Y-K1n9/Audio-Amplifier/Report/Full Circuit Analysis.pdf

1 | P a g e

# PROJECT

# SIMULATION

# AUDIO AMPLIFIER

# TEAM

### YOGESH KRISHNA – 2024102035 ANUMAY RAI – 2025122013

## TABLE NUMBER – 10 ROOM – N117

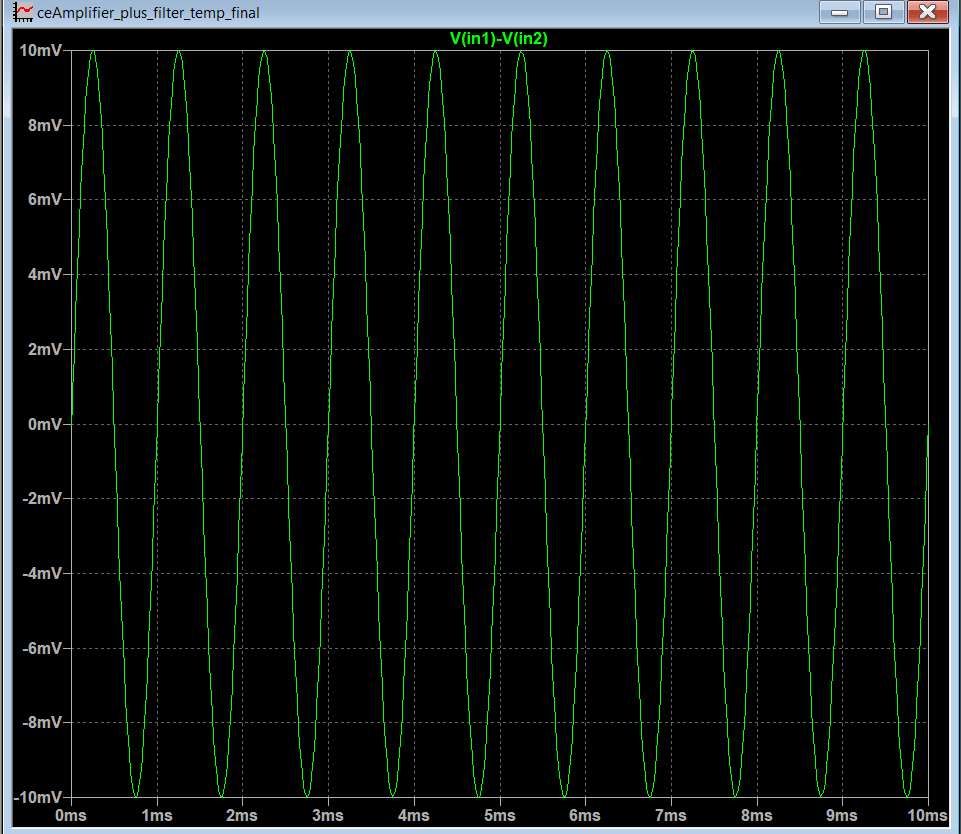
[picture p1: figure]
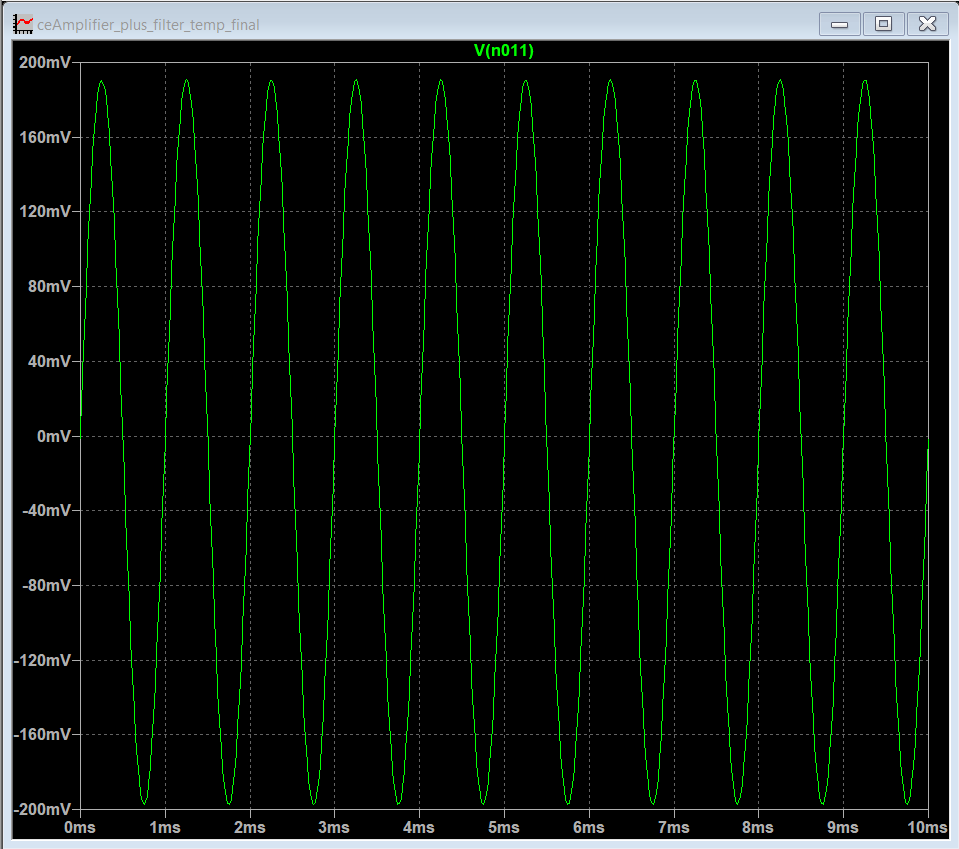
[picture p2: figure]

2 | P a g e

Input Voltage

Output of Differential Circuit

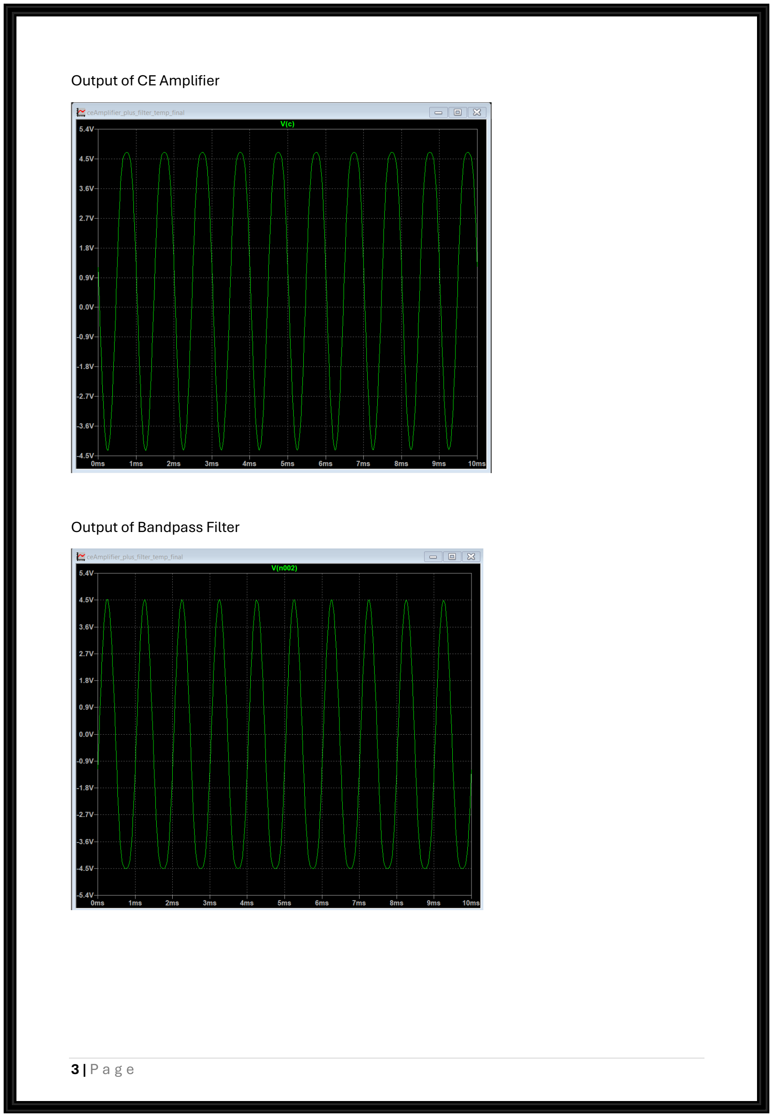
[picture p3: page 3]

3 | P a g e

Output of CE Amplifier

Output of Bandpass Filter

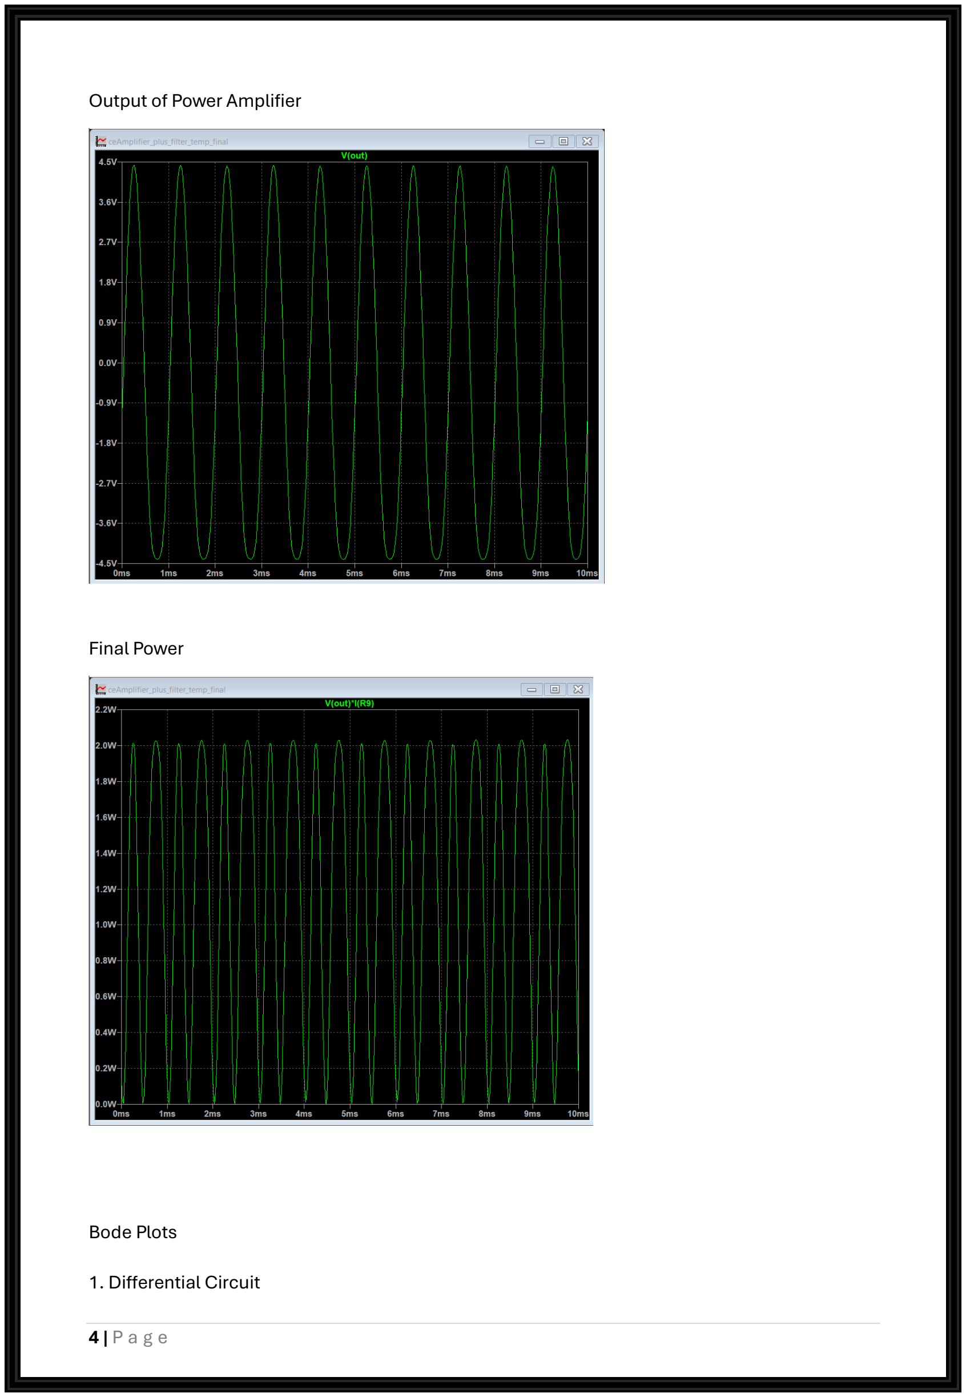
[picture p4: page 4]

4 | P a g e

Output of Power Amplifier

Final Power

Bode Plots

1. Differential Circuit

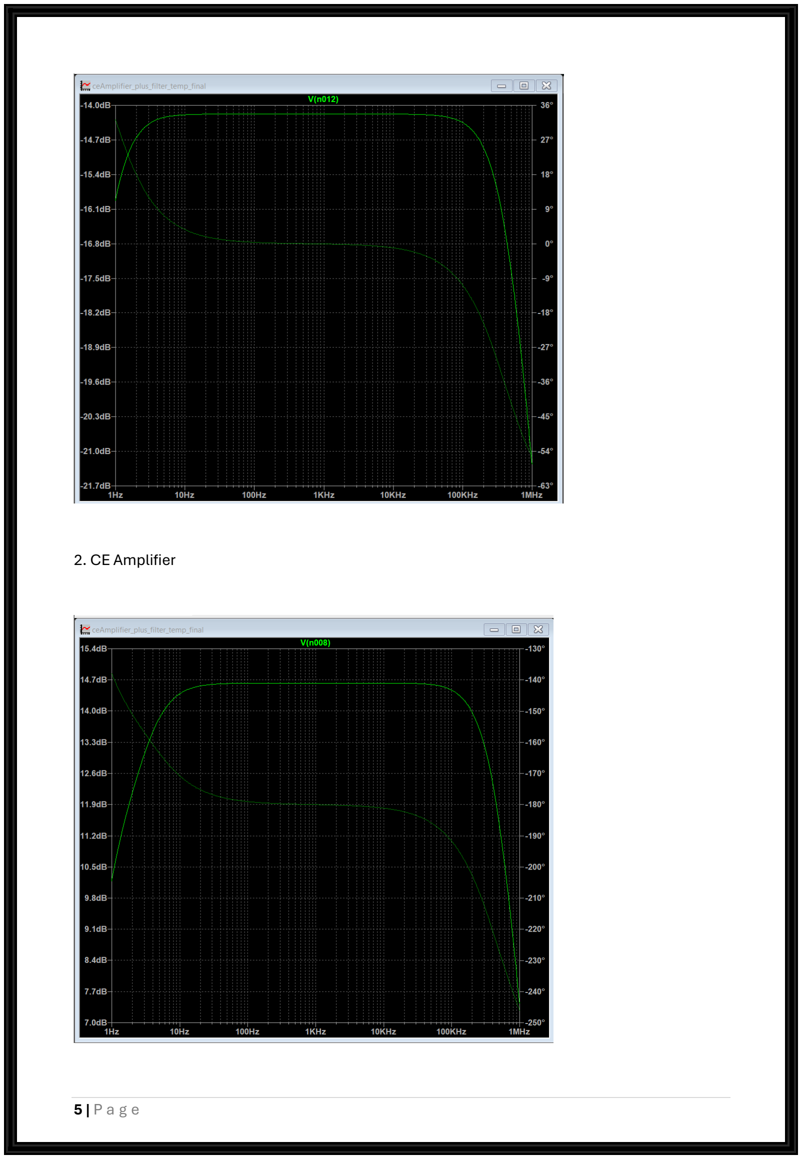
[picture p5: page 5]

5 | P a g e
2. CE Amplifier

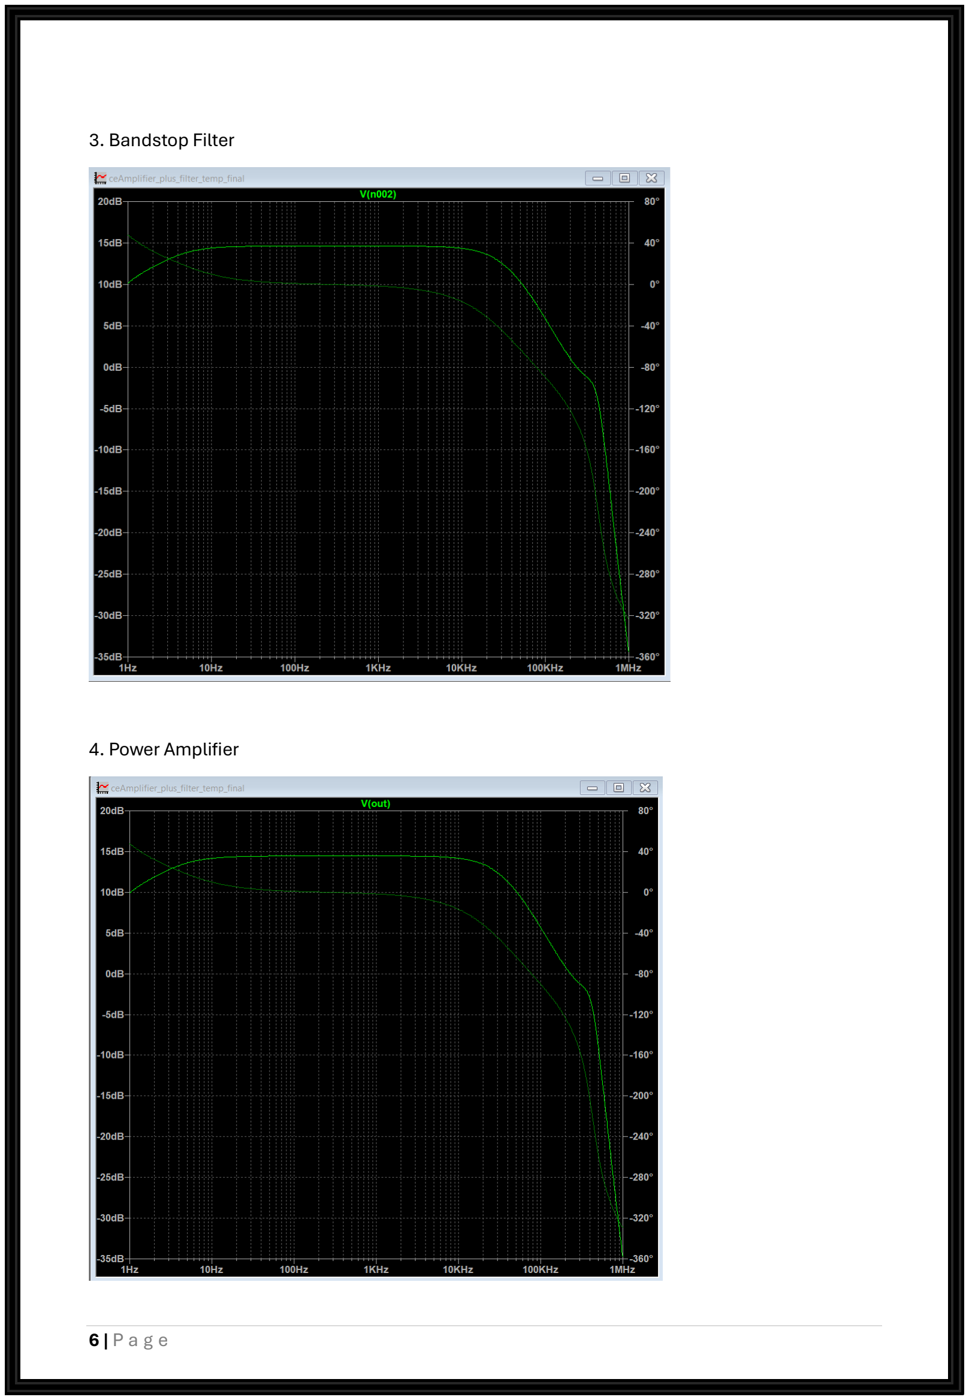
[picture p6: page 6]

6 | P a g e
3. Bandstop Filter
4. Power Amplifier

7 | P a g e

Gain Stages
1. Pre- Amplifier Gain –
a) 20mV pk-pk at 1kHz = 19.2
b) 10mV pk-pk at 1KHz = 19.4
2. Amplifier Gain
a) 20mV pk-pk at 1KHz = 24.0
b) 10mV pk-pk at 1KHz = 26.8
3. Filter Gain
c) 20mV pk-pk at 1KHz = 1
d) 10mV pk-pk at 1KHz = 1
4. Amplifier Gain
e) 20mV pk-pk at 1KHz = 0.97
f) 10mV pk-pk at 1KHz = 0.98
5. Overall Gain
g) 20mV pk-pk at 1KHz = 449.5
h) 10mV pk-pk at 1KHz = 508.9
6. Overall Gain(Without Power Amplifier)
i) 20mV pk-pk at 1KHz = 459.5
j) 10mV pk-pk at 1KHz = 519.3

Parameters
1. Common Mode Rejection Ratio(CMRR) = 30.4dB
2. Slew Rate = 0.057 V/μs
3. Total Harmonic Distortion (THD)
a) 20mV pk-pk at 1kHz = 11.862086%
b) 10mV pk-pk at 1kHz = 3.893069%
4. Stability Factor (S) = 11.1048
