Y-K1n9/Audio-Amplifier/Report/Table_10_2024102035_2025122013 (1).pdf

## EW2 Project 1

## Audio Amplifier Design Report

Team 10

Anumay Rai, 2025122013
Yogesh Krishna, 2024102035

March 5, 2026

## Contents

1 Introduction | 4
2 Microphone Input Circuit | 5
3 Differential Amplifier (Pre-Amplifier Stage) | 6
4 Common-Emitter (CE) Gain Stage | 16

EW2 Project 1 — Audio Amplifier Design | Team 10
5 Active Band-Pass Filter Stage (20 Hz – 20 kHz) | 26
6 Power Amplifier Stage (Class AB) | 32

7 Overall Performance and Analysis | 40
8 Conclusion | 50
9 Link to Demo on Hardware Circuit | 50

## 1 Introduction

### 1.1 Project Overview

The objective of this project is to design a multi-stage audio amplifier capable of ampli-fying weak audio signals to a level suitable for driving a loudspeaker. The design must operate within the audio frequency band of 20 Hz to 20 kHz, provide sufficient voltage and power gain, and maintain low distortion.

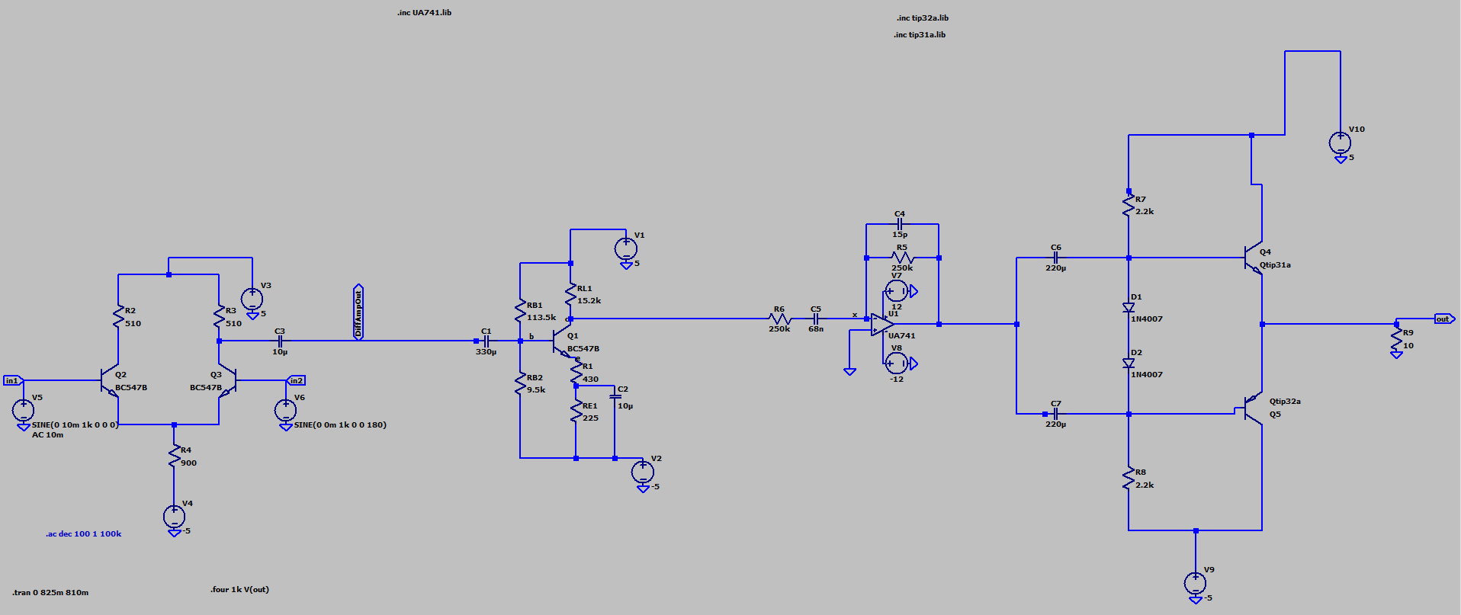
[picture p7: figure]

Figure 1: LTSpice Schematic of Audio Amplifier

### 1.2 Amplifier Architecture

The amplifier comprises four cascaded stages:

1. Differential Amplifier (Pre-Amplifier): Provides initial voltage gain with high common-mode rejection.
2. Common-Emitter (CE) Gain Stage: Provides the bulk of the voltage gain.
3. Active Band-Pass Filter: Limits the signal bandwidth to the audio range (20 Hz
- 20 kHz) with unity or sub-unity gain.
4. Class AB Power Amplifier: Provides current gain (power gain) to drive a low-impedance load (speaker) at unity voltage gain.

### 1.3 Supply Voltage

The circuit operates with a dual-rail supply of VCC = +5 V and VEE = −5 V.

### 1.4 Hardware Implementation of Amplifier Circuit

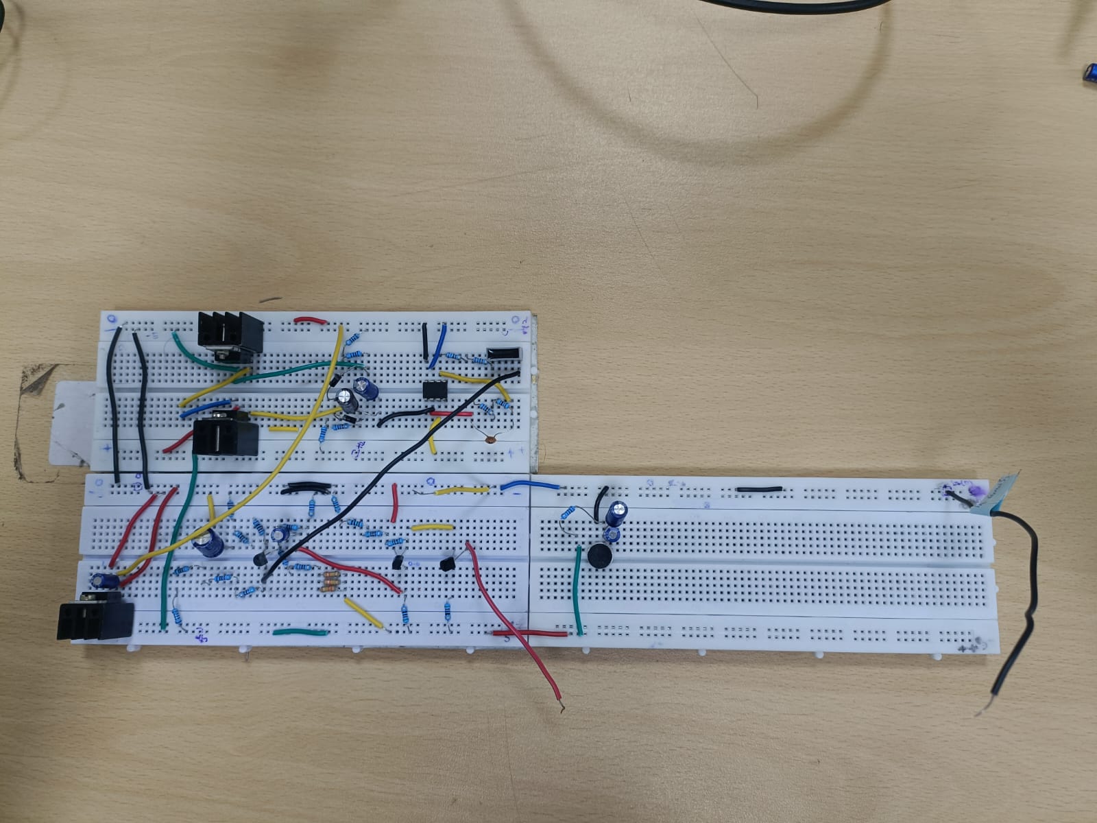
[picture p8: figure]

Figure 2: Hardware Implementation of Amplifier Circuit.

## 2 Microphone Input Circuit

The input signal for the amplifier is obtained from an electric condenser microphone. Such microphones contain a small internal JFET that requires a DC bias current for proper operation. Therefore, a simple biasing circuit is used to provide this current while allowing the generated AC audio signal to be extracted.

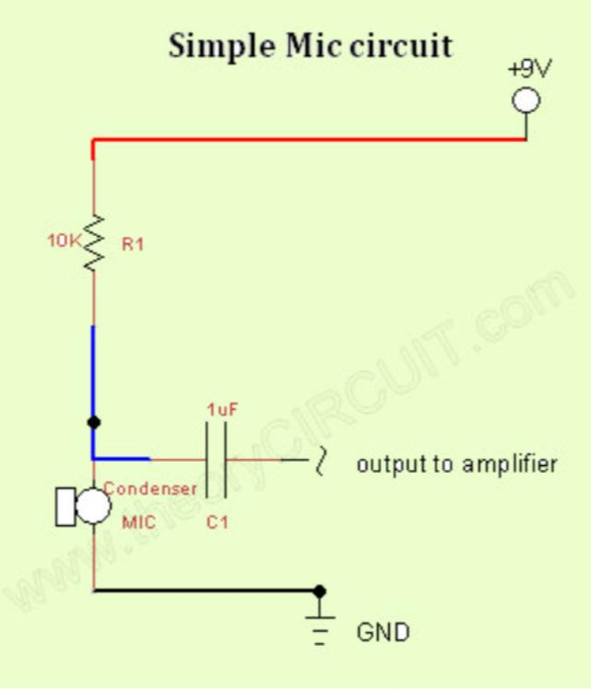
[picture p9: figure]

Figure 3: Electric microphone biasing circuit

The circuit consists of a bias resistor R1(=10kΩ in hardware), a coupling capacitor C1(=57µF in hardware), and the microphone. The resistor R1 connects the microphone to the supply voltage and provides the necessary operating current for the internal JFET to operate in active region.

## 3 Differential Amplifier (Pre-Amplifier Stage)

### 3.1 Theory and Circuit Description

The BJT differential pair is one of the most fundamental building blocks in analog circuit design. It consists of two matched BJT transistors whose emitters are connected together through a common tail resistor RE (or a current source). The circuit amplifies the difference between two input signals while rejecting signals common to both inputs.

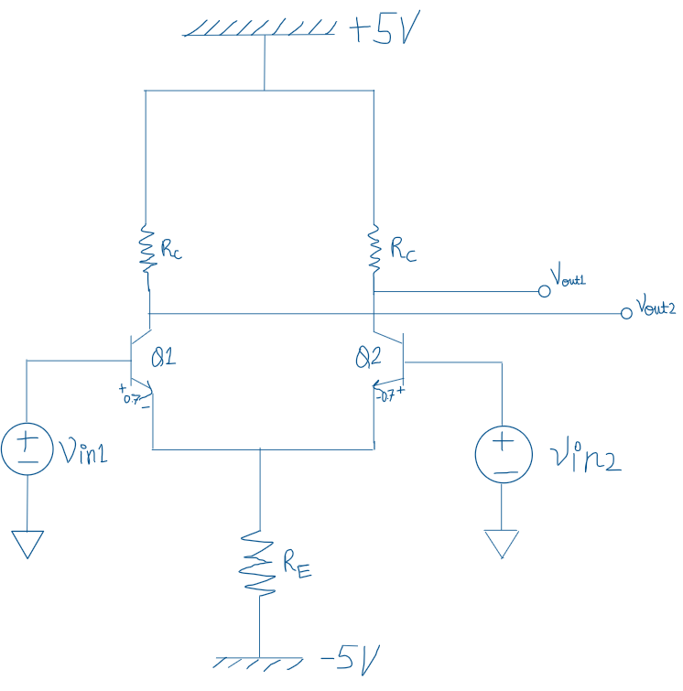
[picture p10: figure]

Figure 4: BJT Differential Pair circuit schematic.

Pre-Amplifier Stage

- The input signal from the microphone cannot be directly fed to the common-emitter or power amplifier because it is very small and susceptible to noise.
- A pre-amplifier is used to increase the signal level to a suitable value (line level) before further amplification.
- The pre-amplifier should have:

– High input impedance to avoid loading the input source.

– Low output impedance to prevent voltage drop at the output.

- In this design, the pre-amplifier stage is implemented using a differential amplifier with a single-ended (unbalanced) output configuration, where one input is connected to the microphone and the other is grounded.

### 3.2 DC Bias Analysis

### 3.2.1 Assumptions

We assume that the base current is negligible (IB ≈ 0 A), which is valid for high-β transistors. Since both transistors are matched:

IC1 = IC2, | IE1 = IE2

and IC ≈ IE (since β ≫ 1).

### 3.2.2 KVL Analysis

Applying KVL from the base of BJT 1 through the emitter to VEE:

−0.7 − IERE = −5

IERE = 4.3

IE =

4.3
RE

(1)

Applying KCL at the emitter node:

IE1 + IE2 = IE | (2)

Since both transistors are matched: IE1 = IE2 =

IE
2

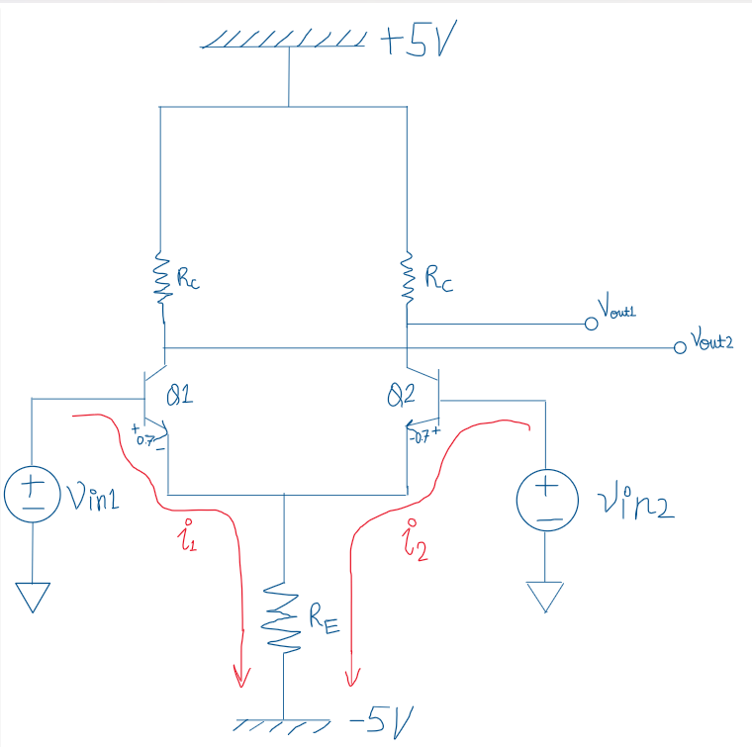
[picture p11: figure]

Figure 5: BJT Differential Pair circuit schematic.

### 3.3 Small-Signal AC Analysis and Gain Derivation

### 3.3.1 Small-Signal Model

In the small-signal analysis, all DC sources are set to zero and the transistors are replaced by their hybrid-π equivalent models. The key small-signal parameter is:

re =

VT
IE

=

1
gm

where VT ≈ 25 mV at room temperature (300 K) and gm is the transconductance.

### 3.3.2 Derivation of Differential Gain

Applying KVL in BJT 1 and BJT 2 small-signal loops:

vin1 − ie1re − (ie1 + ie2)RE = 0 | (1)
vin2 − ie2re − (ie1 + ie2)RE = 0 | (2)

Rearranging into standard form:

ie1(re + RE) + ie2RE = vin1 | (3)
ie1RE + ie2(re + RE) = vin2 | (4)

In matrix form:
re + RE | RE
RE | re + RE

ie1

ie2

=
vin1

vin2

The determinant of the coefficient matrix is:

∆ = (re + RE)

2 − R

2
E = r

2
e + 2REre

By Cramer’s rule:

ie1 =

(RE + re)vin1 − REvin2
r

2
e + 2REre

(3)

ie2 =

(RE + re)vin2 − REvin1
r

2
e + 2REre

(4)

The differential output voltage is:

vout = vo2 − vo1 = (ie1 − ie2)RC

Substituting equations (3) and (4):

vout =

(RE + re)vin1 − REvin2
r

2
e + 2REre

−

(RE + re)vin2 − REvin1
r

2
e + 2REre
RC

=

(RE + re)(vin1 − vin2) + RE(vin1 − vin2)
r

2
e + 2REre
- RC

=

(2RE + re)(vin1 − vin2)
re(re + 2RE)
- RC

=

RC
re
(vin1 − vin2) | (5)

Since the differential input vin = vin1 − vin2:

Ad =

vout

vin

= −

RC
re
= −gmRC | (6)

This is the standard differential gain formula for a BJT differential pair. The negative sign indicates signal inversion.

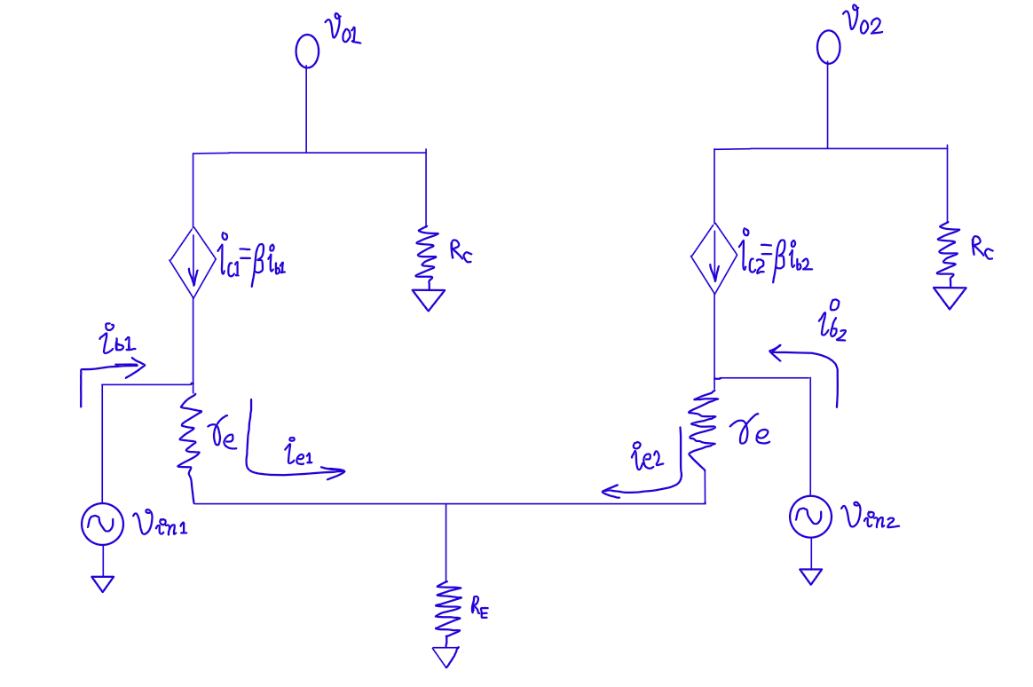
[picture p12: figure]

Figure 6: BJT Differential Pair circuit schematic.

### 3.4 Component Value Design

Setting the target differential gain |Ad| = 49:

gmRC = 49 =⇒

ICRC
VT

= 49

Since IC ≈

IE
2

and the tail current is

IE =

4.3
RE
we have

IC =

4.3
2RE
Substituting:

49 =

ICRC
VT

49 =

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
49 × 2VT
4.3

=

49 × 2 × 0.025
4.3

=

2.45
4.3

≈ 0.57

Chosen component values:

RE = 900 Ω, | RC = 510 Ω | (7)

Verification:

IE =

4.3
900 | = 4.78 mA

IE1 = IE2 =

4.78
2

= 2.39 mA

gm =

IC
VT

=

2.39 × 10⁻³
25 × 10⁻³

= 0.0956 S

Achieved differential gain:

|Ad| = gmRC

|Ad| = 0.0956 × 510 ≈ 48.8

|Ad| ≈ 49

Reason for Gain Reduction in Simulation:
The calculated differential gain of the differential pair is

Ad = gmRC ≈ 49 which represents the differential gain measured between the two collector outputs. However, the output is taken from only one collector (single-ended output). For a differential amplifier, the single-ended gain is approximately half of the differential gain:

Av =

Ad
2
Thus,

Av ≈

49
2

≈ 24.5

which matches the simulated gain of approximately 24. This reduction occurs because the differential signal is shared between the two collector outputs.

### 3.5 Input and Output Impedance

### 3.5.1 Input Impedance (Rin)

The input impedance looking into the base of either transistor is:

Rin = rπ =

β
gm

=

VT β
IC

Standard derivation: From the hybrid-π model, rπ =

vbe
ib

. Since ic = gmvbe and
ic = βib:

rπ =

vbe
ib

=

ic/gm
ic/β =

β
gm
Using the previously calculated current:

IC = 2.39 mA

gm =

IC
VT

=

2.39 × 10⁻³
25 × 10⁻³

= 0.0956 S

Assuming β = 100:

Rin = rπ =

β
gm

Rin =

100
0.0956

Rin ≈ 1.05 kΩ

Rin ≈ 1.05 kΩ | (8)

### 3.5.2 Output Impedance (Rout)

The output impedance is the parallel combination of the collector resistor and the output resistance of the transistor:

Rout = RC ∥ ro

where ro models the Early voltage effect:

ro =

VA
IC
Assuming VA = 100 V:

ro =

100
0.00239

≈ 41.8 kΩ

Since RC ≪ ro:

Rout = (510 ∥ 41.8 k) Ω

Rout ≈ 503 Ω

Rout ≈ 510 Ω | (9)

### 3.6 Common-Mode Rejection Ratio (CMRR)

### 3.6.1 Theory

The CMRR quantifies the ability of a differential amplifier to reject common-mode signals relative to differential signals. It is defined as:

CMRR =

|Ad|
|Ac|

or in decibels:
CMRR (dB) = 20 log10
|Ad|
|Ac|

### 3.6.2 Common-Mode Gain and CMRR

For a common-mode input (vin1 = vin2 = vcm), both transistors conduct equally. Applying KVL for the common-mode half-circuit:

vcm = iere + 2ieRE

ie =

vcm
re + 2RE
The common-mode output at each collector is

vo,cm = −ieRC

Substituting ie,

vo,cm = −

RC
re + 2RE

vcm

Thus the common-mode gain is

Ac =

vo,cm

vcm

= −

RC
re + 2RE
Since re ≪ 2RE, the expression simplifies to

Ac ≈ −

RC
2RE
Using the designed component values
RC = 510 Ω, | RE = 900 Ω
Ac ≈ − | 510 2 × 900

Ac ≈ −0.283

Theoretical common-mode gain:

|Ac| ≈ 0.28

From LTSpice AC analysis, the common-mode gain obtained is

Ac ≈ 0.0027

Using this value,

CMRR = 20 log10
| 49

0.0027

CMRR ≈ 85 dB

Reason for Difference
The theoretical derivation uses simplified small-signal assumptions such as perfect transistor symmetry and the approximation re ≪ 2RE. However, a full transistor model is used which includes parameters such as transistor gain, Early effect, and internal resistances. These effects improve the common-mode rejection of the differential pair, resulting in a much smaller common-mode gain in simulation.

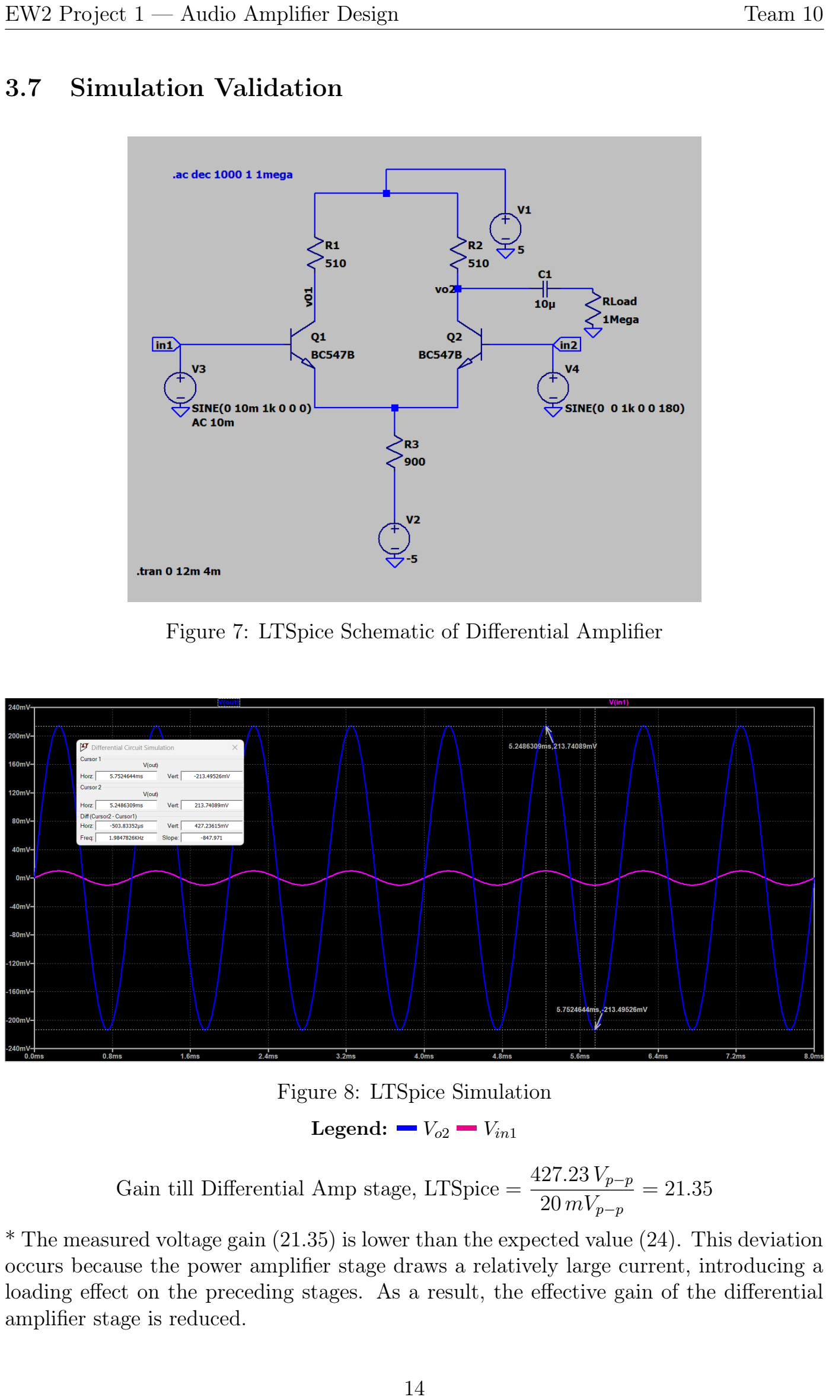
[picture p13: page 14]

### 3.7 Simulation Validation

Figure 7: LTSpice Schematic of Differential Amplifier

Figure 8: LTSpice Simulation

Legend: | Vo2 | Vin1

Gain till Differential Amp stage, LTSpice =

427.23 Vp−p
20 mVp−p

= 21.35

* The measured voltage gain (21.35) is lower than the expected value (24). This deviation occurs because the power amplifier stage draws a relatively large current, introducing a loading effect on the preceding stages. As a result, the effective gain of the differential amplifier stage is reduced.

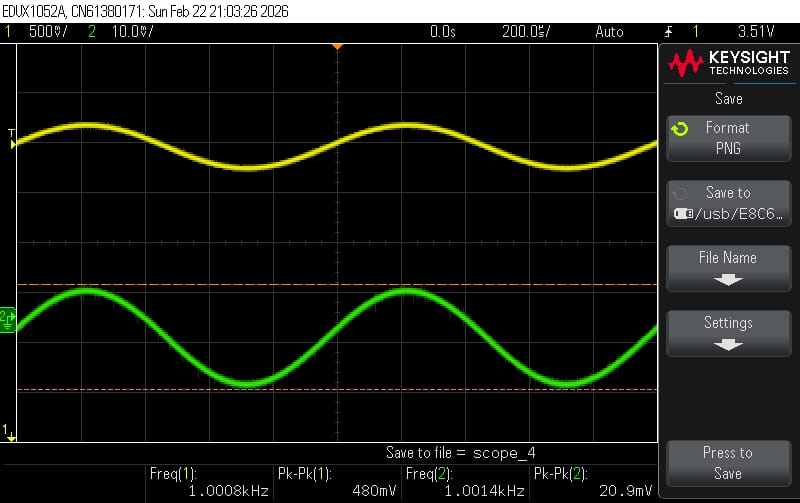
[picture p14: figure]

Figure 9: Scope output of hardware implementation: Differential Amplifier Output

Legend: | Input (Vin1) | Output (Vo2)

Gain till Differential Amp stage, Hardware =

480 Vp−p
20 mVp−p

= 24

## 4 Common-Emitter (CE) Gain Stage

### 4.1 Theory and Circuit Description

In our design, a partially-bypassed emitter resistor configuration of single-transistor CE amplifier is used.

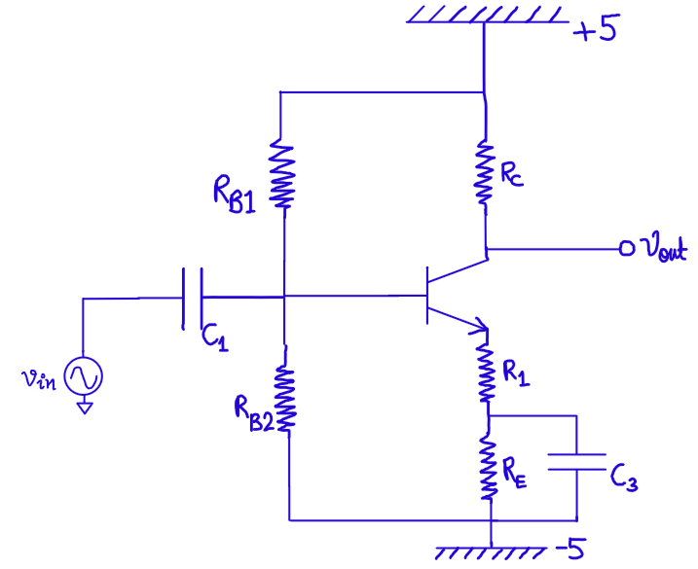
[picture p15: figure]

Figure 10: CE amplifier schematic

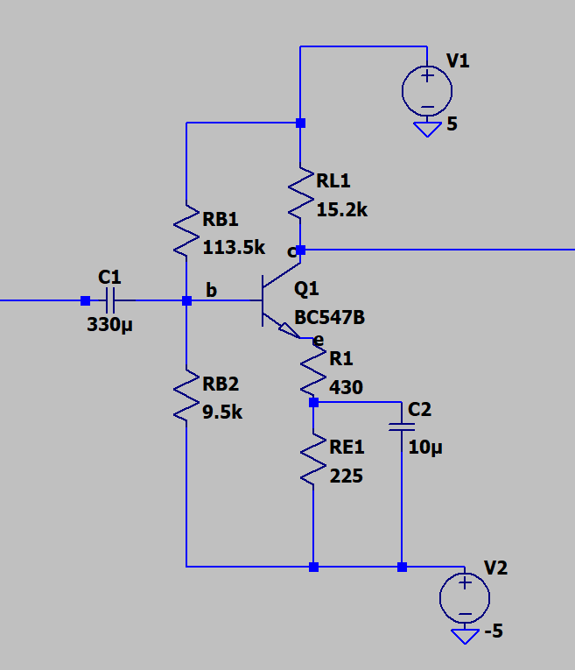
[picture p16: figure]

Figure 11: LTSpice Circuit

### 4.1.1 Amplifier Configuration Choice

The CE configuration was chosen because:

- It provides the highest voltage gain among the three basic BJT configurations (CE, CB, CC).
- It provides moderately high input impedance, suitable for receiving the signal from the differential amplifier stage.

### 4.2 DC Bias Design (Voltage Divider Bias)

We have used a voltage divider bias for implementing the biaging network for the CE amplifier stage. It uses two resistors (RB1 and RB2) to set the DC base voltage inde-pendent of β. This significantly improves thermal stability as it creates a robust voltage divider, the quiescent base voltage VB remains relatively constant even if the transistor’s characteristics shift due to temperature variations.

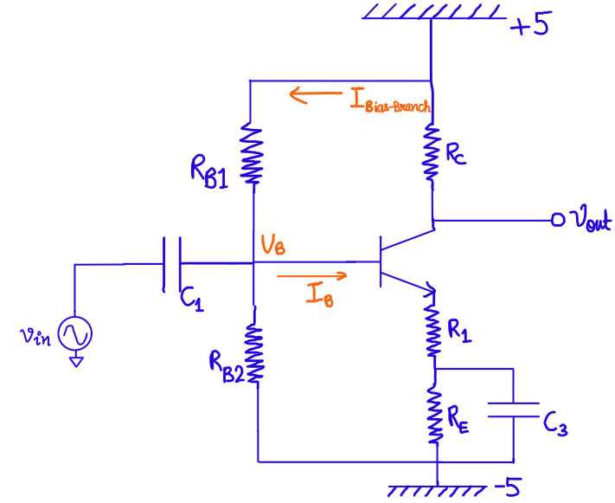
[picture p17: figure]

Figure 12: Biasing Network

### 4.2.1 Design Calculations

To achieve a perfectly symmetrical maximum swing, we bias the DC collector voltage (VCQ) exactly at the midpoint of the rails (0 V).
The output voltage of a CE amplifier is the collector voltage VC. This voltage is physically constrained between two limits:
- Upper Swing Limit: If VC attempts to rise above VCC, the transistor enters cutoff. The output clips at VCC.
- Lower Swing Limit: VC,min = VE + VCE,sat. If VC drops too low and approaches VE, the transistor enters saturation (VCE,sat ≈ 0.2 V).

By setting VE = −4.9 V, we push the lower swing limit as low as possible. This creates the largest possible range for VC = Vout to swing, which maximizes output swing. To achieve the symmetrical maximum swing, the DC quiescent collector voltage VCQ is be biased at the midpoint of the output range. In our design, VCQ ≈ 0 V.

Setting VE = −4.9 V and VC = 0V , for BJT to be in active region, we make the biasing network such that it constrains VB to be:

VB = VE + VBE = −4.9 + 0.7 = −4.2 V | (10)

By KVL, assuming IB ≪ IBias−branch:

5 − VB

RB1

=

VB + 5

RB2

On Rearranging,

5(RB2 − RB1) = VB(RB1 + RB2)

Substituting VB = −4.2 V and simplifying, we find the ratio of the biasing resistors:

RB1

RB2

=

23
2
| = 11.5 | (11)

We select a value for RB2 and RB1 which would be nearly, of the order of magnitude RB1 ≈ 100kΩ and RB2 ≈ 10kΩ so that the Input impedance of the CE Amplifier stage remains fairly above the output impedance of Differential Amplifier Stage(≈ 503Ω) to prevent Amplitude degradation due to loading, Thus, based on these considerations and iterative optimization we choose:

RB1 ≈ 113.5 kΩ, | RB2 ≈ 9.5 kΩ | (12)

Note that the ratio RB1
RB2

≈ 11.94, which is not significantly different from the initially derived ratio.

### 4.2.2 Bias Current Verification

The bias branch current through the voltage divider:

IBias-branch =

10
15 × 10³

= 86 µA ≫ IB

For worst-case BC547 transistor, β = 200:

IB =

IC
β

=

1 × 10⁻³
200

= 5 µA

Since IB ≪ IBias-branch, the assumption of negligible IB in bias calculations was con-sistent and valid.

### 4.2.3 Verification of Active Region of Operation

To ensure the BJT remains in the Forward Active region, the following two conditions need to be satisfied:

1. Base-Emitter Junction (Forward Bias): VBE ≥ VBE,on, typically ≈ 0.7 V. In our voltage divider network, this is maintained by Equation 10. Since we ensure VB = −4.24 V and VE = −4.94 V(exact value in LTSpice), we have:

VBE = −4.24 V − (−4.94 V) = 0.7 V

2. Collector-Base Junction (Reverse Bias): VCE > VCE,sat, (VCE,sat ≈ 0.2 V) By biasing VE at −4.94 V, the collector voltage VC can swing as low as −4.74 V before the transistor enters saturation. Since our quiescent point VCQ is biased at 0 V, the transistor remains safely in the active region for the majority of the output signal range.

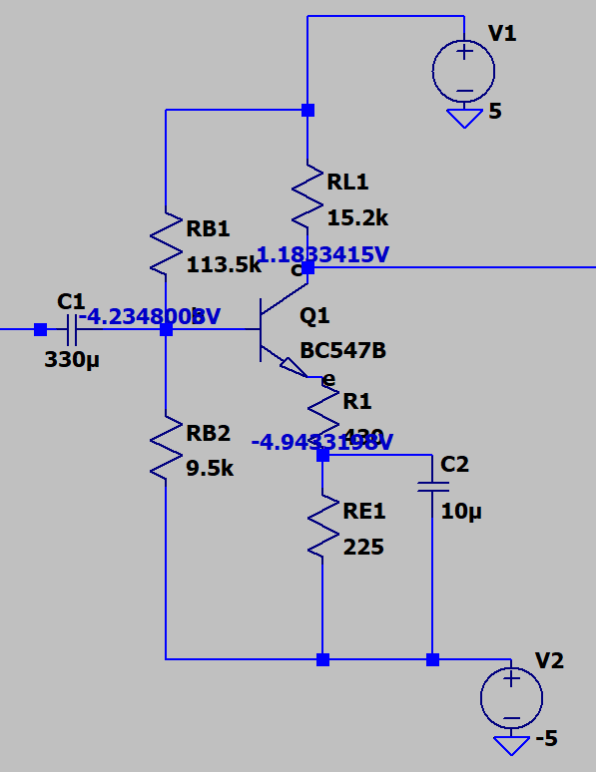
[picture p18: figure]

Figure 13: CE amplifier bias points

- Base DC Voltage:
VBQ = -4.23V
- Emitter DC Voltage:
VEQ = -4.94V
- Collector DC Voltage:

VCQ = 1.184V VCE = VCQ − VEQ = 6.124 > VCE,sat
since VCE,sat ≈ 0.2V and, VBE = 0.71V >0.7V Hence, we conclude that our transistor is in active region of operation (Maximum value of Vout is 4.5V above 0V so, VC stays below 5V -> No clipping)

### 4.3 Small-Signal Gain Calculation

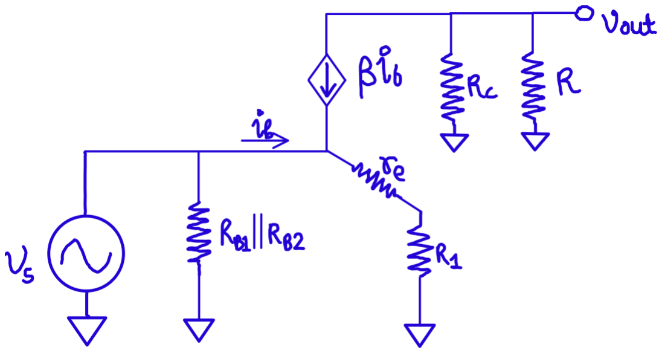
[picture p19: figure]

Figure 14: CE amplifier small–signal schematic.

### 4.3.1 Gain Expression

Applying KVL:

vs − (β + 1)iB(re + R1) = 0

vs = (β + 1)iB(re + R1)

vout = −βiB(RC ∥ R)

vout
vs

= −

β

β + 1
RC ∥ R
re + R1

Av = −

RC ∥ R
re + R1

(13)

where re = VT /IE is the intrinsic small-signal emitter resistance. Now, we assume Load resistance R is very large (the input impedance of Bandpass filter)
Now, since VC is biased at 0 V, by DC analysis:

IC =

VCC − VC
RC

=

5
RC

Av = −

RC
re + R1

Av = −

RC
VT
IE

+ R1

(14)

### 4.3.2 Design Equations for R1 and RE

Setting IE ≈ IC = 5/RC, we derive the ratio R1/RC:

−

RC

RC VT
5 + R1

= Av

−

1

VT
5 +

R1
RC

= Av

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
|Av|

−

VT
5

(15)

By DC analysis, we have current in Emitter branch IE, (as capacitance C3 acts as open–circuit for DC signals):

IE =

5 + VE
RE + R1
Now, for the ratio RE/RC:
|Av| =

RC

R1 +

VT (R1+RE)
5+VE
1
|Av|

=

R1
RC
1 +

VT
5 + VE
+

RE
RC

·

VT
5 + VE
Now, we put the ratio R1/RC found in eq. 15 to get:

1
|Av|

=

1
|Av|

−

VT
5

1 +
VT
5 + VE
+

RE
RC
VT
5 + VE

1
|Av|
5 + VE
VT
=
1
|Av|

−

VT
5

5 + VE
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
|Av|
5 + VE
VT
−

1
|Av|

+

5 + VE
5
+

VT
5

+

1
|Av|
5 + VE
VT

RE
RC

=

5 + VE + VT
5
−

1
|Av|

(16)

### 4.3.3 Numerical Computation

Setting Av = 30:
R1
RC

=

1
30

−

26 × 10⁻³
5

= 0.02813

Found DC value of VE = -4.83V from LTSpice.

RE
RC

=

5 − 4.83 + 0.026
5

−

1
30

= 0.005867

With RC = 15 kΩ:

R1 = 0.02813 × 15 × 10³ = 422 Ω | (17)
RE = 0.005867 × 15 × 10³ = 88 Ω | (18)

The expected values from the calculations were:

RC = 15 kΩ, | RE = 88 Ω, | R1 = 422 Ω | (19)

Note: These values were adjusted through iterative optimization in simulation to account for non-ideal effects. The following are the exact resistance values used in the LTSpice simulation. Using these values, the gain of this stage was obtained as Av ≈ 22.5.

RC = 15.2 kΩ, | RE = 225 Ω, | R1 = 430 Ω

### 4.4 Input and Output Impedance

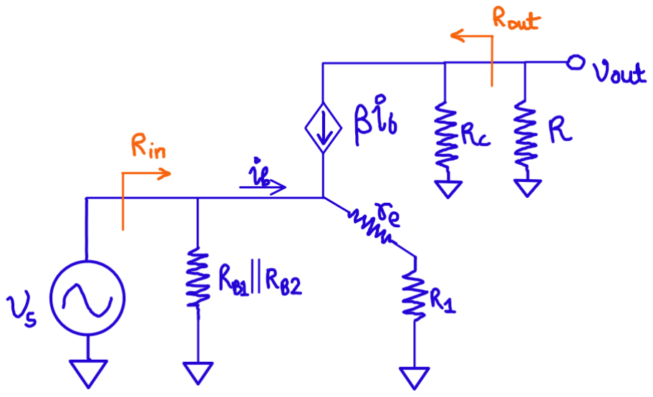
[picture p20: figure]

Figure 15: Input and Output impedances of CE Amplifier.

### 4.4.1 Input Impedance

Using the method of impedance reflection:

Rin = RB1∥RB2∥β(re + R1)

Substituting values:

re =

VT
IE

=

VT · RC
5

=

0.026 × 15000
5

= 78 Ω

β(re + R1) = 200 × (78 + 430) = 200 × 508 = 101.6 kΩ

Rin = (113.5 k∥9.5 k∥101.6 k) Ω

Rin ≈ 8.07 kΩ | (20)

Simulation value: Rin = 8.77 kΩ (close agreement with calculated value).

### 4.4.2 Output Impedance

Rout = RC∥ro

Since ro (Early voltage resistance) is very large:

Rout ≈ RC = 15.25 kΩ | (21)

### 4.5 Maximum Output Swing

### 4.5.1 Theory

The output voltage of a CE amplifier is the collector voltage VC. This voltage is physically constrained between two limits:

1. Upper Swing Limit: If VC tries to go above VCC, the transistor cuts off. The output clips at VCC.
2. Lower Swing Limit: VC,min = VE + VCE,sat. If VC drops too low and approaches VE, the transistor enters saturation (VCE,sat ≈ 0.2 V).

### 4.5.2 Design for Maximum Swing

By setting VE = −4.94 V, we push the lower swing limit as low as possible. This creates the largest possible swing for VC = Vout to move, which maximizes output swing. To achieve a symmetrical maximum swing, the DC quiescent collector voltage VCQ has been biased at the midpoint of the output range. Here, VCQ ≈ 0 V (midpoint of the rails).

### 4.5.3 Calculation

Vo,min = VE + VCE,sat = −4.94 + 0.2 = −4.74 V

Vo,max = VCC = 5 V

Vpp,max = VCC − (VE + VCE,sat) = 5 − (−4.94 + 0.2) = 9.74 V

Vpp,max = 9.74 V, | Vo,min = −4.74 V, | Vo,max = 5 V | (22)

### 4.5.4 Input Signal Limits

The maximum input signal that can be applied without clipping the output:

Vin,pp,max =

Vout,pp,max
|Av|

=

9.74
25

≈ 389.6 mVpp

### 4.6 Integration of First Two Stages

The differential amplifier (gain ≈ 18) drives the CE amplifier (gain ≈ 25). The combined gain of the first two stages:

Av,total = Ad × Av,CE = 21.75 × 22.56 = 490.68 (≈ 452.18 in simulation)

Loading considerations: The output impedance of the differential stage (Rout ≈ 503 Ω) is by design, much smaller than the input impedance of the CE stage (Rin ≈ 8.77 kΩ) which allows for minimal signal loss. We use a coupling capacitor C1 for blocking the DC components of the input signal.
Capacitances used in the CE-Amp and Coupling capacitor for integration:
- Input coupling capacitor: Capacitor C1 forms a high pass filter with the input impedance of CE amplifier stage. We keep C1 = 330µF, so that this capacitor basically acts only as a DC block and filtering is handled by the Band-Pass stage.
- Emitter Bypass Capacitor: Capacitor C3 allows better DC bias control (RE sets DC bias) and increases AC gain by bypassing the RE resistor.

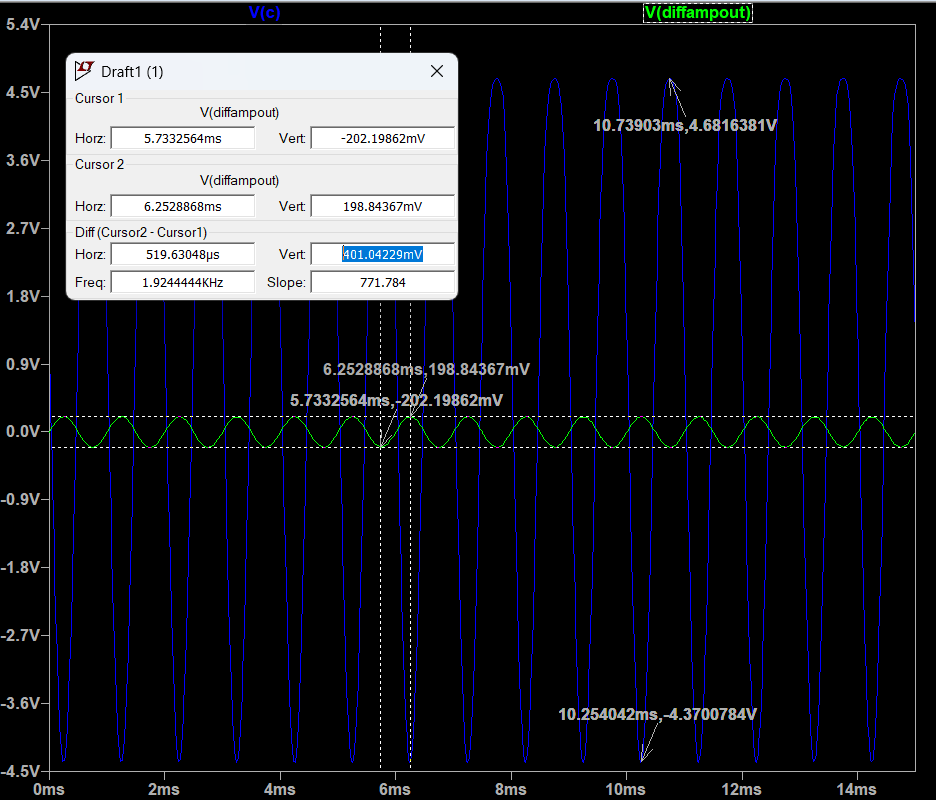
[picture p21: figure]

Figure 16: LTSpice output of CE amplifier stage

Legend: | Input (Vin1, 401mVp−p) | Output (Vo1, 9.05Vp−p)

Gain till CE Amplifier stage, LTSpice =

9.05 Vp−p
20 mVp−p

= 452.5

## Gain contribution from this stage:

Voltage Gain of CE amp stage |Av| =

9.05V
401.04mV p − p

= 22.56

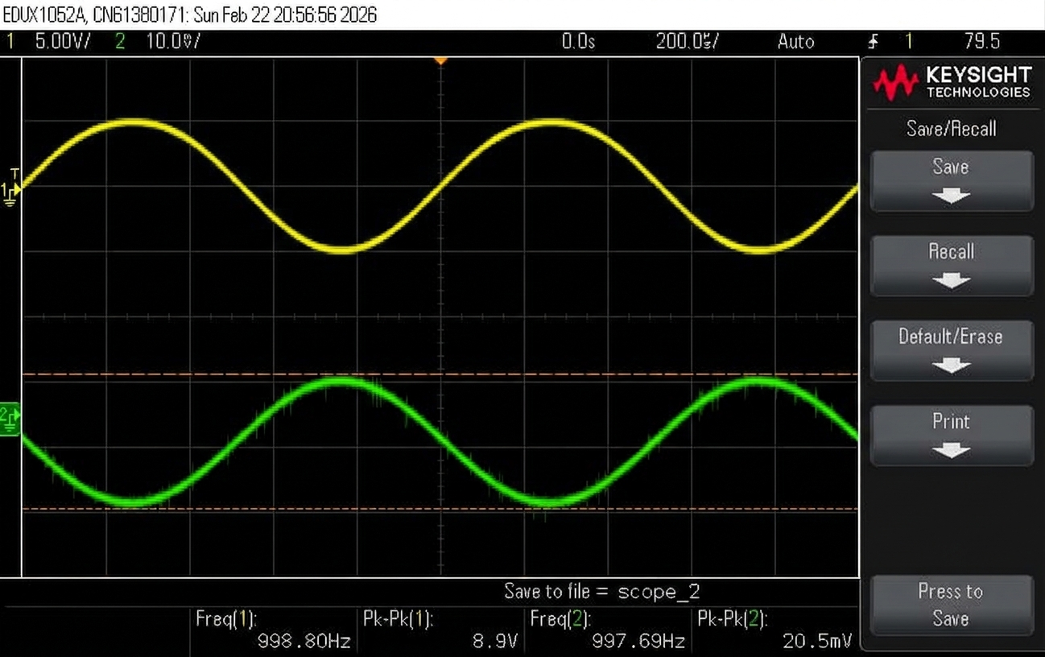
[picture p22: figure]

Figure 17: Scope output of hardware implementation: CE Amplifier and Differential pair.

Legend: | Input (Vin1) | Output (Vo1)

Gain till CE Amplifier stage, Hardware =

8.9 Vp−p
20 mVp−p

= 445

## 5 Active Band-Pass Filter Stage (20 Hz – 20 kHz)

### 5.1 Theory and Overview

We design an active Bandpass filter to allow only frequencies in the audible range (20Hz-20KHz) while attenuating other frequencies. To achieve this, we have implemented a bandpass filter with a low cutoff frequency at 10 Hz and a high cutoff frequency at 40 kHz.

### 5.1.1 Band-Pass Implementation

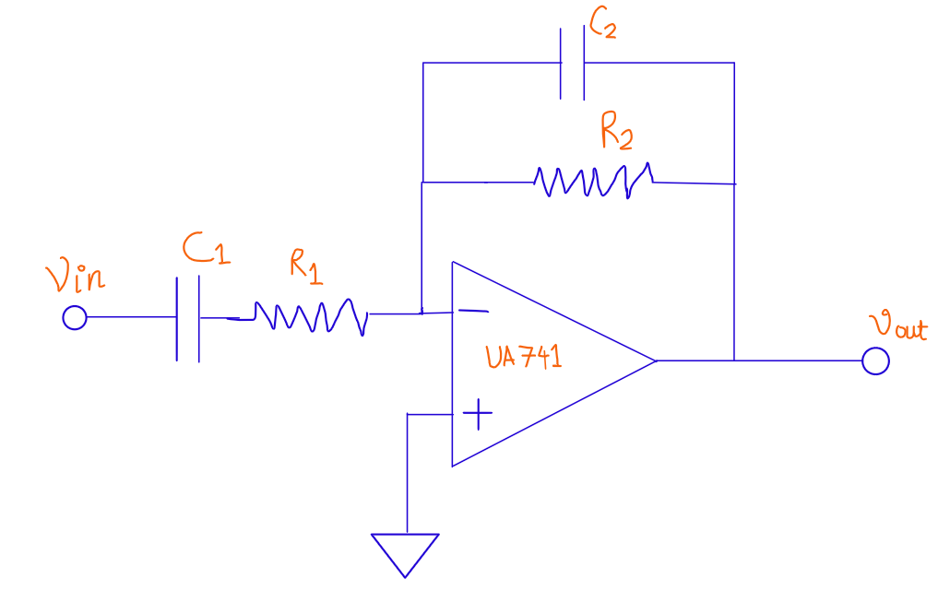
[picture p23: figure]

Figure 18: Band Pass Filter Circuit

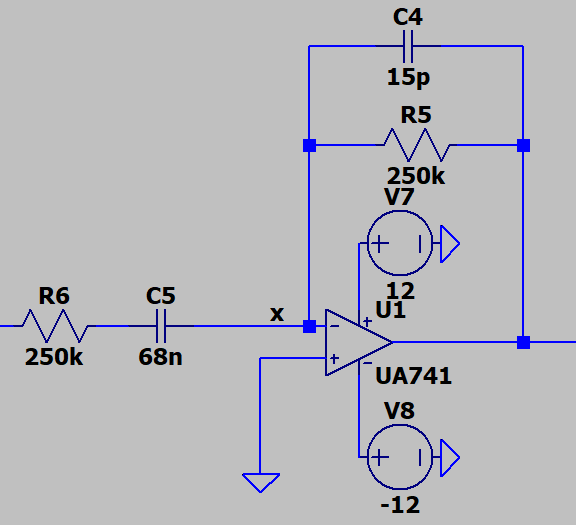
[picture p24: figure]

Figure 19: LTSpice BPF Circuit

The band-pass filter is implemented using an inverting op-amp configuration with following impedances:

- Input impedance Zi: A series combination of R1 and C1 (forms a high-pass section with cutoff ωL = 1/(R1C1)).
- Feedback impedance Zf : A parallel combination of R2 and C2 (forms a low-pass section with cutoff ωH = 1/(R2C2)).

This creates a band-pass response: the circuit passes frequencies between ωL and ωH while attenuating frequencies outside this range.

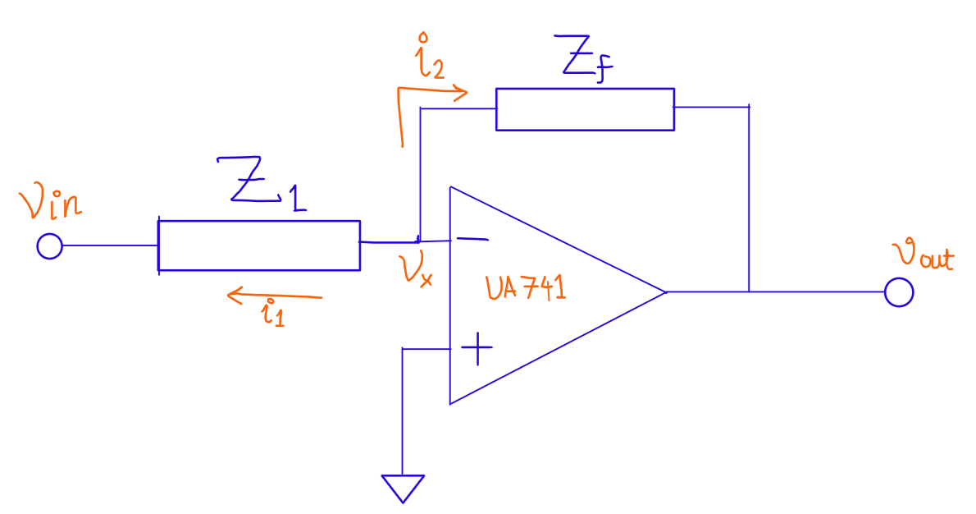
[picture p25: figure]

Figure 20: Inverting Configuration

### 5.2 Transfer Function Derivation

Reference: Band Pass Filter Circuit

### 5.2.1 Virtual Ground Analysis

Due to the virtual short in the inverting op-amp configuration:

VX = 0 V | (1)

Applying KCL at the inverting input node:

i2 − i1 = 0 =⇒

VX − Vi
Zi

+

VX − Vo
Zf

= 0

Substituting VX = 0:
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
(23)

### 5.2.2 Substituting Complex Impedances

The feedback impedance (parallel R2 and C2):

Zf = R2∥

1
sC2

=

R2
1 + sR2C2

The input impedance (series R1 and C1):

Zi = R1 +

1
sC1

=

sR1C1 + 1
sC1

Therefore:

Vo(s)
Vi(s)

= −

R2/(1 + sR2C2)
(sR1C1 + 1)/(sC1)

= −

sR2C1
(1 + sR2C2)(1 + sR1C1)

Multiplying numerator and denominator:

H(s) = Vo(s)
Vi(s)

= −

sR2C1
(1 + sR2C2)(1 + sR1C1)

(24)

### 5.3 Frequency Response Analysis

### 5.3.1 Frequency Domain Transfer Function

Substituting s = jω:
H(jω) = | −jωR2C1
| (1 + jωR2C2)(1 + jωR1C1)
Expanding the denominator:
H(jω) = | −jωR2C1
1 + jω(R1C1 + R2C2) − ω²R1C1R2C2

### 5.3.2 Resonant Frequency

The magnitude |H(jω)| is maximized at resonant frequency i.e. ω = ωres:

ωres =

1
√
R1C1R2C2

(25)

Cutoff frequencies from transfer function are:

ωL =

1
R1C1

, ωH =

1
R2C2

The resonant frequency is the geometric mean:

ωres =

√
ωL · ωH | (26)

### 5.3.3 Magnitude at Resonance

At ω = ωres:
|H(jω)|ω=ωres =

R2C1
R1C1 + R2C2

=

R2
R1

·

C1
C1 + C2 ·

R2
R1
Design choice: C1 ≫ C2. Under this condition:

|H(jω)|ω=ωres ≈

R2
R1

To ensure the gain is ≤ 1 everywhere in the passband:

R1 = R2 | (27)

This ensures unity passband gain (0 dB gain), so the filter stage does not add any voltage amplification.

### 5.4 Cutoff Frequency Design

### 5.4.1 Resistor Selection

We set R1 = R2 = 250 kΩ.
Rationale: The input impedance of the filter stage must be much greater than the output impedance of the CE amplifier (Rout,CE = 15.25 kΩ) to prevent loading:

R1 = 250 kΩ ≫ 15.25 kΩ

Thus, we’ve successfully evaded the possibility of Loading of CE amplifier output.

### 5.4.2 Lower Cutoff Frequency (ωL = 10 Hz)

Note: The lower cutoff frequency is set to 10 Hz (below the 20 Hz audio range) to ensure the 20 Hz signal is in the passband with minimal attenuation.

ωL =

1
R1C1

= 2π × 10

C1 =

1
ωLR1

=

1
2π × 10 × 250 × 10³
C1 = 63.66 nF | (28)

We used standard value C1 = 68nF.

### 5.4.3 Upper Cutoff Frequency (ωH = 40 kHz)

Note: The upper cutoff frequency is set to 40 kHz (above the 20 kHz audio range) to ensure minimal attenuation at 20 kHz.

ωH =

1
R2C2

= 2π × 40 × 10³

C2 =

1
ωHR2

=

1
2π × 40 × 10³ × 250 × 10³
C2 = 15.9 pF | (29)

We used standard value C1 = 15pF.

### 5.4.4 Chosen Component Values

After selecting standard component values:

- fL =

1
2πR1C1

=

1
2π×250k×68 nF = 42.44 kHz
- fH =

1
2πR2C2

=

1
2π×250k×15 pF = 9.36 Hz

### 5.5 AC Response and Bode Plot Analysis

The Bode plot of the band-pass filter H(jω) has the following characteristics:

- Below ωL: The gain increases at +20 dB/decade (high-pass behavior from the sR1C1 term).
- Between ωL and ωH (passband): The gain is approximately constant at 0 dB (since R1 = R2).
- Above ωH: The gain decreases at −20 dB/decade (low-pass behavior from the R2C2 feedback).

In the passband, phase is approximately −180 (inverting amplifier).

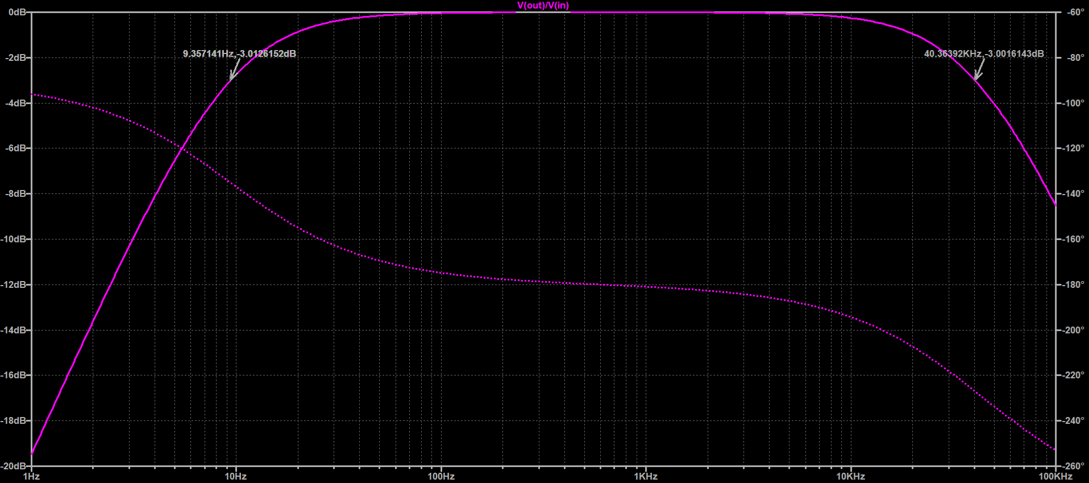
[picture p26: figure]

Figure 21: LTSpice Bode Plot Filter stage

Legend: | Magnitude | Phase
Lower Cutoff Frequency (-3dB Cutoff) fL: | 9.357141 Hz, at, −3.0126152 dB
Upper Cutoff Frequency (-3dB Cutoff) fH: | 40.36392 kHz, at − 3.0016143 dB

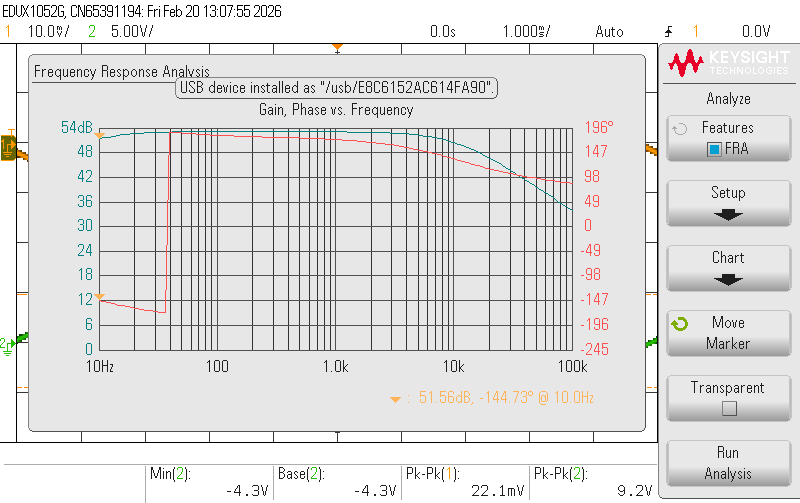
[picture p27: figure]

Figure 22: Bode Plot of Output till Filter stage

Legend: | Magnitude | Phase

### 5.6 Input and Output Impedance

### 5.6.1 Output Impedance

Assuming an ideal op-amp (output impedance ≈ 0 Ω):

Rout = 0 Ω | (30)

This feature of low output impedance allows this stage to drive the subsequent power amplifier stage without loading. This is one of the key reasons we chose Active filters over Passive Filters.

### 5.6.2 Input Impedance

Looking into the circuit from the input terminal:

Rin =

1
jωC1

+ R1

|Rin| =

s
1
ω²C²
1

+ R²
1 ≈ R1 | (for ω ≫ 1/(R1C1))
Rin ≈ 290 kΩ | (31)

This is sufficiently large to prevent loading of the CE amplifier stage.

## 6 Power Amplifier Stage (Class AB)

### 6.1 Theory

### 6.1.1 Need for a Power Amplifier Stage

The preceding stages (differential amplifier, CE stage, filter) provide voltage gain but cannot deliver significant current to a low-impedance load such as a loudspeaker (typically 4 Ω to 16 Ω). The power amplifier stage provides:

- High current gain (current buffering).
- Unity voltage gain - the signal amplitude is preserved.
- Low output impedance to drive the speaker.

### 6.1.2 Why Class AB?

Different amplifier classes have different tradeoffs:

Class | Efficiency | Linearity Crossover Distortion
A | Low (∼ 25%) | Excellent | None
B | High (∼ 78%) | Poor | Severe
AB | Moderate (50–70%) | Good | Minimal

Table 1: Comparison of amplifier classes.

Class AB is the optimal choice for audio amplification because:

- It eliminates the crossover distortion inherent in Class B by keeping both output transistors slightly on near the zero-crossing region.
- It provides much better efficiency than Class A.
- It maintains good signal fidelity across the audio range.

### 6.1.3 Push-Pull Configuration

A Class AB push-pull stage uses a complementary pair of transistors:

- An NPN transistor handles the positive half-cycle of the output.
- A PNP transistor handles the negative half-cycle.
- A small bias current (Ibias) flows through both transistors at the quiescent point, ensuring both are slightly on to avoid crossover distortion.

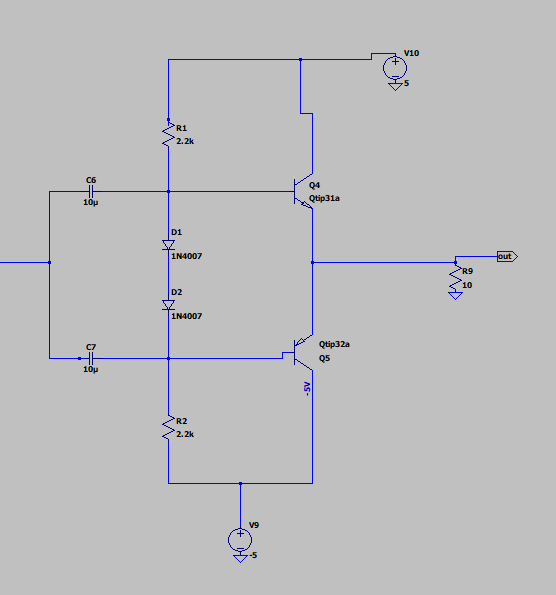
[picture p28: figure]

Figure 23: Class AB push-pull output stage circuit.

### 6.2 Circuit Configuration and Biasing

### 6.2.1 Biasing for Class AB Operation

The bias voltage between the bases of the NPN and PNP transistors is set to approximately:

Vbias ≈ 2VBE ≈ 1.4 V

This is achieved using two silicon diodes placed between the transistor bases. To maintain proper diode conduction, a bias current of approximately:

Ibias ≈ 2 mA

is selected.
The total supply voltage across the bias network is:

Vtotal = VCC − VEE = 5 − (−5) = 10 V

Voltage across bias resistors:

VR = Vtotal − Vbias

VR = 10 − 1.4 = 8.6 V

Thus,

R1 + R2 =

VR

Ibias

R1 + R2 =

8.6
0.002

R1 + R2 = 4.3 kΩ
Choosing symmetrical biasing:

R1 = R2 ≈ 2.2 kΩ
This maintains a stable bias voltage of approximately 1.4 V between the transistor bases.

### 6.2.2 Coupling Capacitor Design

The capacitors C6 and C7 act as coupling capacitors that block DC while allowing the AC signal to pass to the Class AB output stage. These capacitors form a high-pass RC network with the input resistance of the bias network.
The cutoff frequency of a high-pass RC circuit is given by

fc =

1
2πRinC
where Rin is the equivalent input resistance seen by the capacitor and C is the coupling capacitance.
Rearranging the equation to obtain the required capacitance,

C =

1
2πRinfc
In this circuit, the input resistance is determined by the bias resistors R7 and R8:

Rin = R1 ∥ R2

Rin =

R1R2
R1 + R2
Substituting R7 = R8 = 2.2 kΩ,

Rin =

2.2kΩ
2

= 1.1 kΩ

Assuming a lower cutoff frequency of fc = 20 Hz for audio applications,

C =

1
2π(1100)(20)

C ≈ 7.23 µF
Thus, the nearest standard capacitor value is chosen as

C ≈ 10 µF
which ensures proper low-frequency coupling without significant signal attenuation.

### 6.3 Design Derivation and Component Values

### 6.3.1 Output Transistor Selection

We have used complementary transistor pair Tip31C (NPN) and Tip32C (PNP). Key parameters:

- Maximum collector current: I

max
C ≈ 3 A
- Current gain: hF E ≈ 50
- Maximum collector-emitter voltage: VCE(max) ≈ 100 V

These ratings comfortably support our requirements.

### 6.3.2 Component Value Justification

- Bias resistors: R1 = R2 ≈ 2.2 kΩ
- Bias diodes: Two silicon diodes providing ≈ 1.4 V
- Load resistor: RL = 10 Ω

### 6.4 Unity Voltage Gain Verification

The output stage operates as a common-collector (emitter follower) amplifier.

Av =

RL
re + RL
where

re =

VT

| ICQ
Assuming a quiescent current:

ICQ = 50 mA

re =

25mV
50mA

re = 0.5 Ω

Thus,

Av =

10
10 + 0.5

Av = 0.95 ≈ 1

Therefore, the power stage provides unity voltage gain, satisfying the design spec-ification.

### 6.5 Power Output Calculation

### 6.5.1 Theory

Maximum RMS output voltage required for 1.5 W power:

P =

V

2
rms
RL

Vrms =

p
P RL

Vrms =

√
1.5 × 10

Vrms = 3.87 V

Peak output voltage:

Vpeak =

√
2Vrms

Vpeak = 5.47 V

Peak output current:

Ipeak =

Vpeak
RL

Ipeak =

5.47
10

Ipeak = 0.547 A

Thus, each output transistor must handle approximately:

IC ≈ 0.55 A

### 6.5.2 Efficiency

For Class AB amplifiers, the theoretical maximum efficiency approaches:

ηmax ≈ 78.5%

Assuming ideal operation:

Psupply ≈

Pout
η

Psupply ≈

1.5
0.785

Psupply ≈ 1.91 W

Power dissipated in transistors:

Pdiss = Psupply − Pout

Pdiss ≈ 0.41 W

### 6.6 Input and Output Impedance

The power stage uses a complementary transistor pair: TIP31C (NPN) and TIP32C (PNP).
Assuming a quiescent current:

ICQ = 50 mA

The small-signal emitter resistance is

re =

VT

ICQ
where VT ≈ 25 mV .

re =

25 mV
50 mA

re = 0.5 Ω

### 6.6.1 Output Impedance

For an emitter follower stage:

Rout = re +

RS
β + 1
Since the preceding stage has very low source impedance,

RS ≈ 0

Thus,

Rout ≈ re

Rout ≈ 0.5 Ω

This low output impedance allows efficient power transfer to the 10 Ω load.

### 6.6.2 Input Impedance

The input impedance of the emitter follower is given by:

Rin = (β + 1)(RL + re)

Assuming a transistor current gain of

β ≈ 25

Rin = (25 + 1)(10 + 0.5)

Rin = 26 × 10.5

Rin ≈ 273 Ω

Therefore,

Rin ≈ 270 Ω

This impedance is sufficiently high to avoid loading the preceding gain stage while maintaining strong current drive capability.

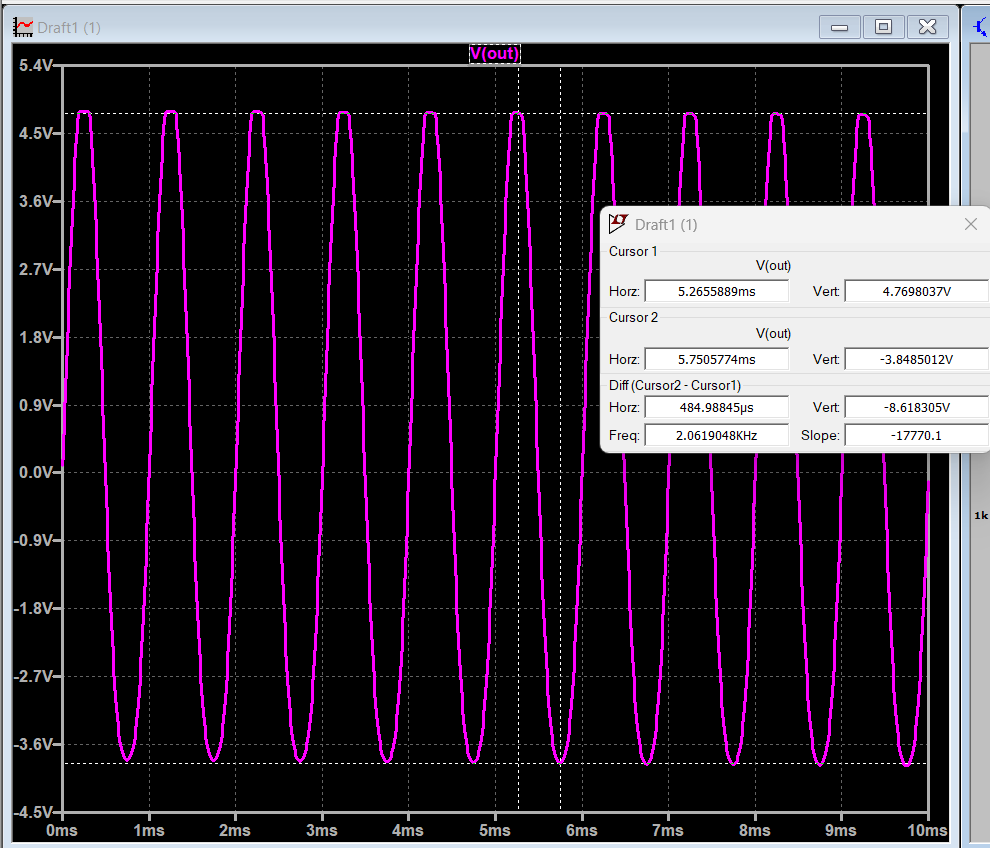
[picture p29: figure]

Figure 24: LTSpice Simulation

Legend: Vout for 20mVpp

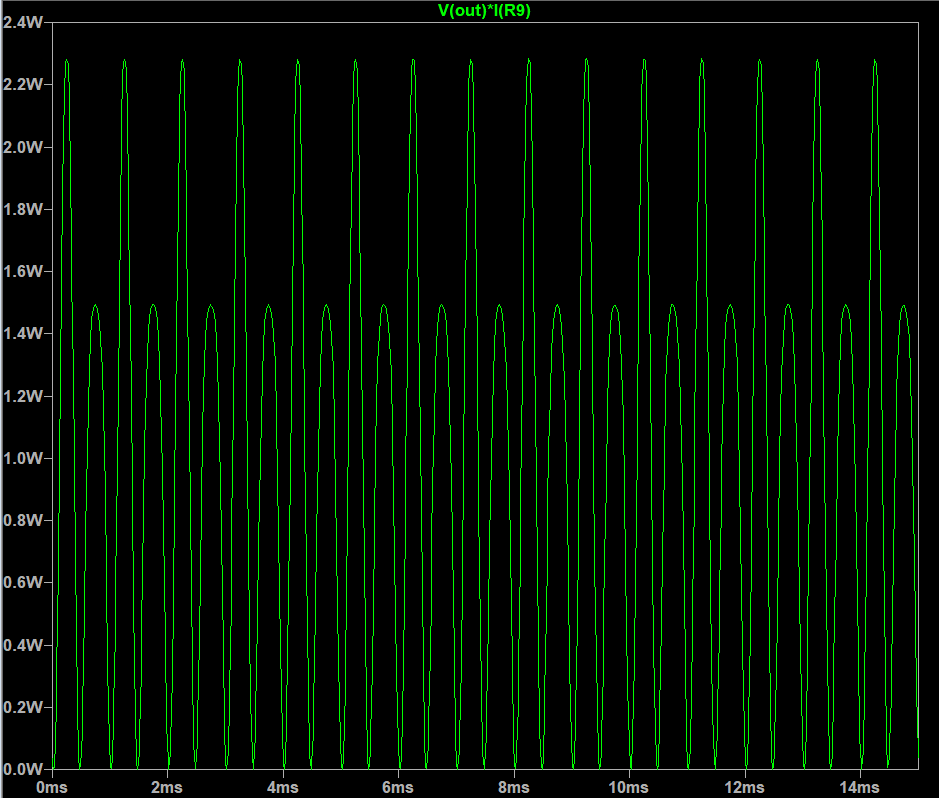
[picture p30: figure]

Figure 25: LTSpice Power Amplifier power output

Legend: Power of Vout for 20mVpp, Peak value of power 2.3W > 1.5W

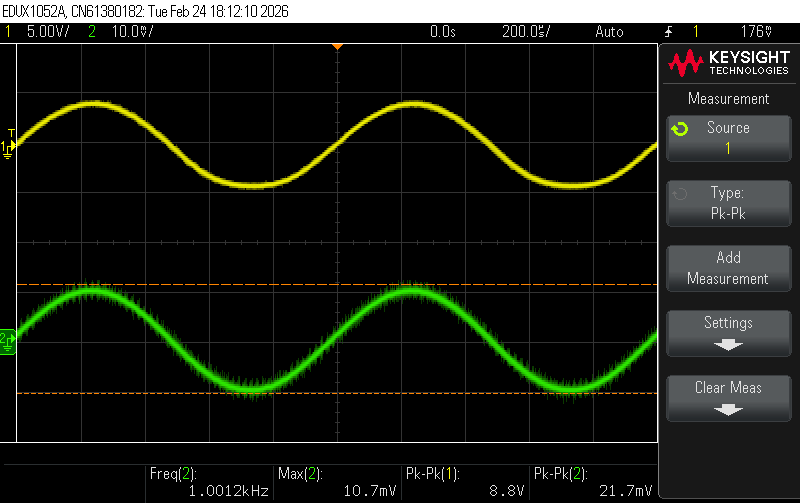
[picture p31: figure]

Figure 26: Scope output of hardware implementation: Power Amplifier Output for 20mVpp input

Legend: | Output(10Ω load) | Input of Differential Pair

## 7 Overall Performance and Analysis

### 7.1 Complete Amplifier Chain

The complete four-stage amplifier chain is:

Input −→ Diff. Amp. Ad −→ CE Stage Av −→ BPF Ac −→ Class AB Ap −→ Speaker

### 7.2 Final Gain Verification

### 7.2.1 AC Analysis (Bode Plot)

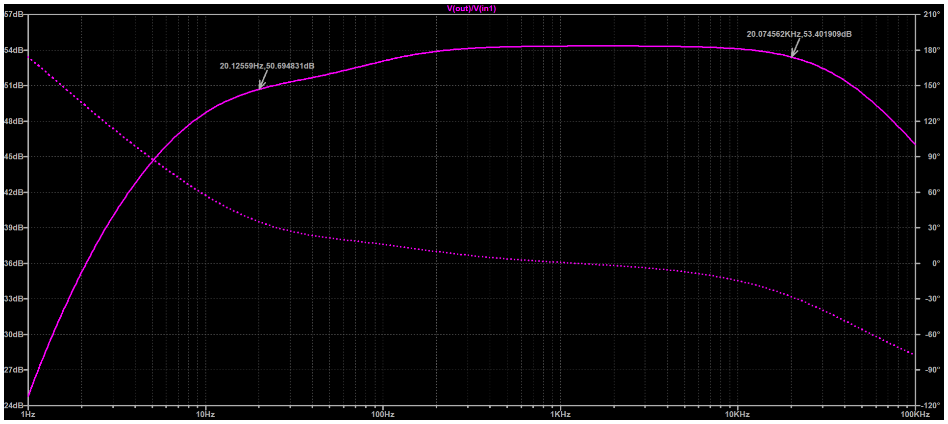
[picture p32: figure]

Figure 27: Output AC Analysis (LT Spice)

Legend: | Magnitude | · · · Phase Plot
Lower–End Operating Band Limit: | 20.12559 Hz, 50.694831 dB
Higher–End Operating Band Limit: | 20.074562 kHz, 53.401909 dB

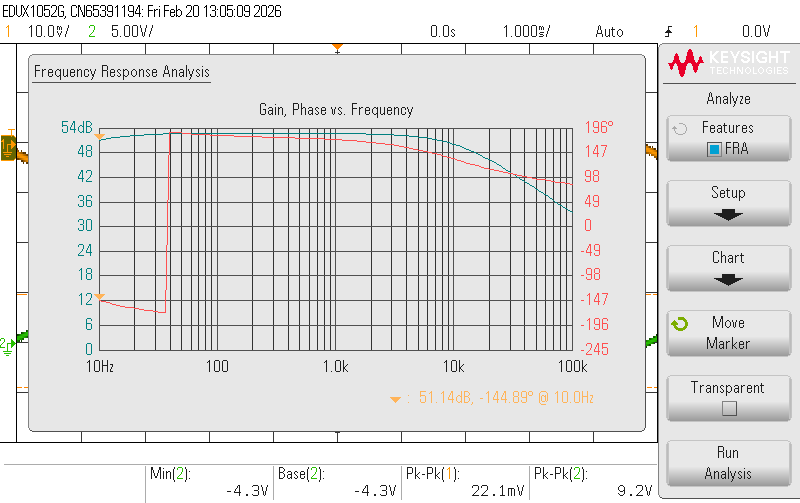
[picture p33: figure]

Figure 28: Output AC Analysis (Hardware)

Legend: | Magnitude | Phase
Lower–End Operating Band Limit: | 20 Hz, 51.5 dB,(approx)
Higher–End Operating Band Limit: | 20 kHz, 48 dB,(approx)

### 7.2.2 Transient Analysis

Figure 29: LTSpice Simulation Overall, 20mVp−pinput

Legend: | Vout
Overall Output Voltage: | 8.63 Vpp
Overall Gain: | 431

Figure 30: Hardware Overall Output, 20mVp-p input

Legend: | Output(10Ω load) | Input of Differential Pair
Overall Output Voltage: | 8.8 Vpp
Overall Gain: | 440

### 7.3 Total Harmonic Distortion (THD) Analysis

### 7.3.1 Theory

Total Harmonic Distortion quantifies the nonlinearity introduced by the amplifier. It is defined as:

THD =

p
V

2
2 + V

2
3 + V

2
4 + · · ·
V1

× 100%

where V1 is the amplitude of the fundamental frequency and V2, V3, . . . are the amplitudes of the harmonics.

### 7.3.2 THD Measurement Method Employed(LTSpice)

In LTSpice, we measure THD using the built-in Fourier analysis tool.

### 7.3.3 THD for Input Sine Wave of 10 mV pk-pk

Harmonic | Frequency | Fourier | Normalized | Phase | Normalized
Number | [Hz] | Component | Component | [degree] | Phase [deg]
1 | 1.000e+03 | 2.533e+00 | 1.000e+00 | 89.24° | 0.00°
2 | 2.000e+03 | 1.026e-01 | 4.049e-02 | 178.46° | 89.22°
3 | 3.000e+03 | 1.961e-02 | 7.742e-03 | 89.21° | -0.03°
4 | 4.000e+03 | 3.978e-03 | 1.571e-03 | 0.39° | -88.85°
5 | 5.000e+03 | 4.227e-04 | 1.669e-04 | -91.74° | -180.98°
6 | 6.000e+03 | 8.432e-05 | 3.329e-05 | 22.27° | -66.97°
7 | 7.000e+03 | 2.166e-05 | 8.550e-06 | 20.59° | -68.65°
8 | 8.000e+03 | 6.175e-05 | 2.438e-05 | 45.85° | -43.39°
9 | 9.000e+03 | 9.220e-05 | 3.640e-05 | 109.87° | 20.63°

Partial Harmonic Distortion: 4.125390%
Total Harmonic Distortion: 4.125782%

### 7.3.4 THD for Input Sine Wave of 20 mV pk-pk

Harmonic | Frequency | Fourier | Normalized | Phase | Normalized
Number | [Hz] | Component | Component | [degree] | Phase [deg]
1 | 1.000e+03 | 3.435e+00 | 1.000e+00 | 89.28° | 0.00°
2 | 2.000e+03 | 2.317e-01 | 6.746e-02 | 178.58° | 89.30°
3 | 3.000e+03 | 5.956e-02 | 1.734e-02 | 89.50° | 0.22°
4 | 4.000e+03 | 1.472e-02 | 4.285e-03 | 0.66° | -88.62°
5 | 5.000e+03 | 2.594e-03 | 7.552e-04 | -90.36° | -179.64°
6 | 6.000e+03 | 7.091e-04 | 2.064e-04 | 3.92° | -85.36°
7 | 7.000e+03 | 2.477e-04 | 7.213e-05 | -88.13° | -177.41°
8 | 8.000e+03 | 2.042e-04 | 5.944e-05 | 24.19° | -65.09°
9 | 9.000e+03 | 1.807e-04 | 5.261e-05 | 102.33° | 13.05°

Partial Harmonic Distortion: 6.978840%
Total Harmonic Distortion: 6.979090%

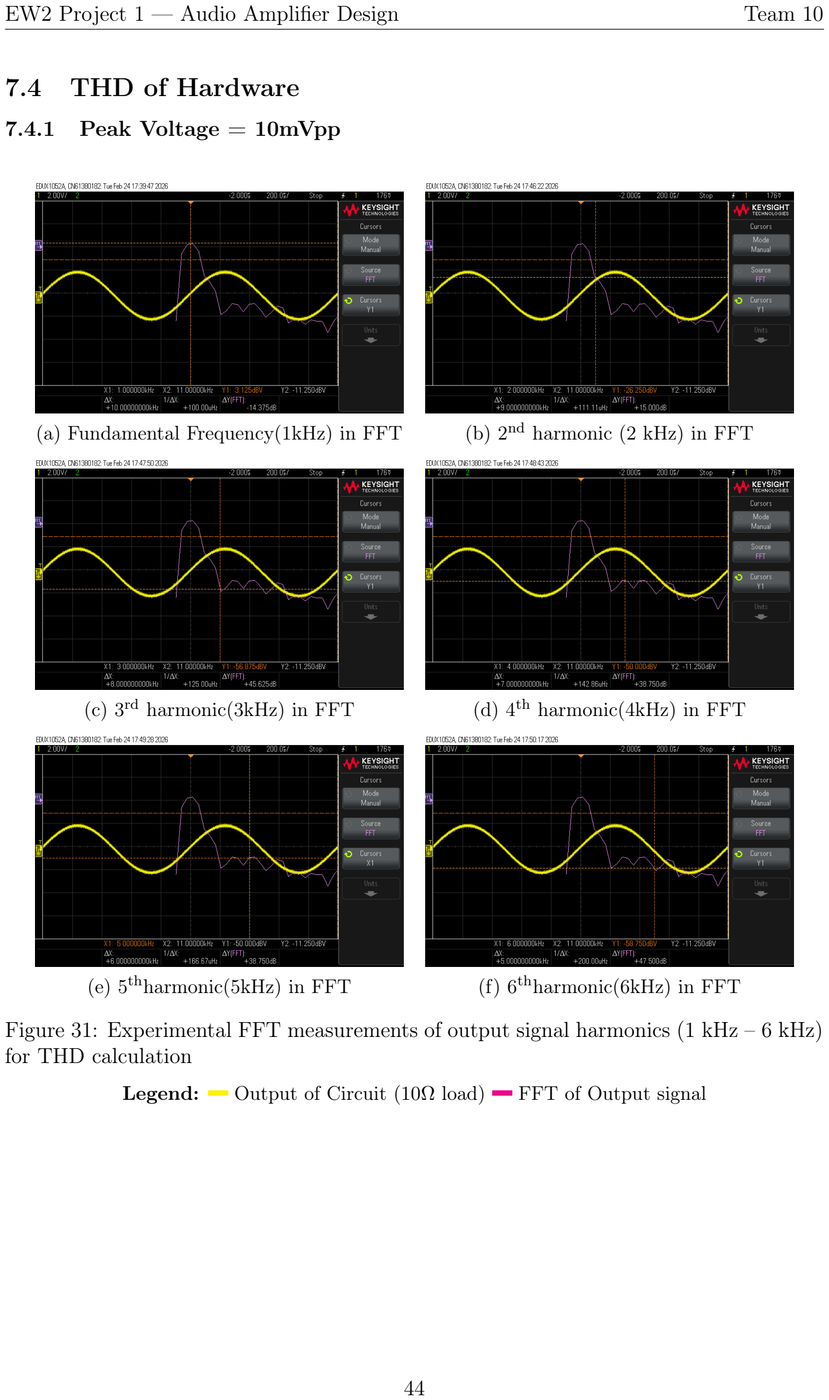
[picture p34: page 44]

### 7.4 THD of Hardware

### 7.4.1 Peak Voltage = 10mVpp

(a) Fundamental Frequency(1kHz) in FFT | (b) 2nd harmonic (2 kHz) in FFT
(c) 3rd harmonic(3kHz) in FFT | (d) 4th harmonic(4kHz) in FFT
(e) 5thharmonic(5kHz) in FFT | (f) 6thharmonic(6kHz) in FFT

Figure 31: Experimental FFT measurements of output signal harmonics (1 kHz – 6 kHz) for THD calculation

Legend: | Output of Circuit (10Ω load) | FFT of Output signal

THD Calculation

- THD at 1 kHz, nominal input level

The harmonic amplitudes obtained from the Fourier analysis are

V1 = 3.125 dBV
V2 = −26.250 dBV
V3 = −56.875 dBV
V4 = −50.000 dBV
V5 = −50.000 dBV
V6 = −58.750 dBV

Converting from dBV to volts using

V = 10⁽dBV/20)

V1 ≈ 1.43 V
V2 ≈ 0.04870 V
V3 ≈ 0.00143 V
V4 ≈ 0.00316 V
V5 ≈ 0.00316 V
V6 ≈ 0.00115 V

The Total Harmonic Distortion (THD) is defined as

THD =

p
V

2
2 + V

2
3 + V

2
4 + V

2
5 + V

2
6
V1

Substituting the values,

p
(0.050)² + (0.00143)² + (0.00316)² + (0.00316)² + (0.00115)² ≈ 0.0502

THD = 0.0502
1.43

≈ 0.03559

THD ≈ 3.56%

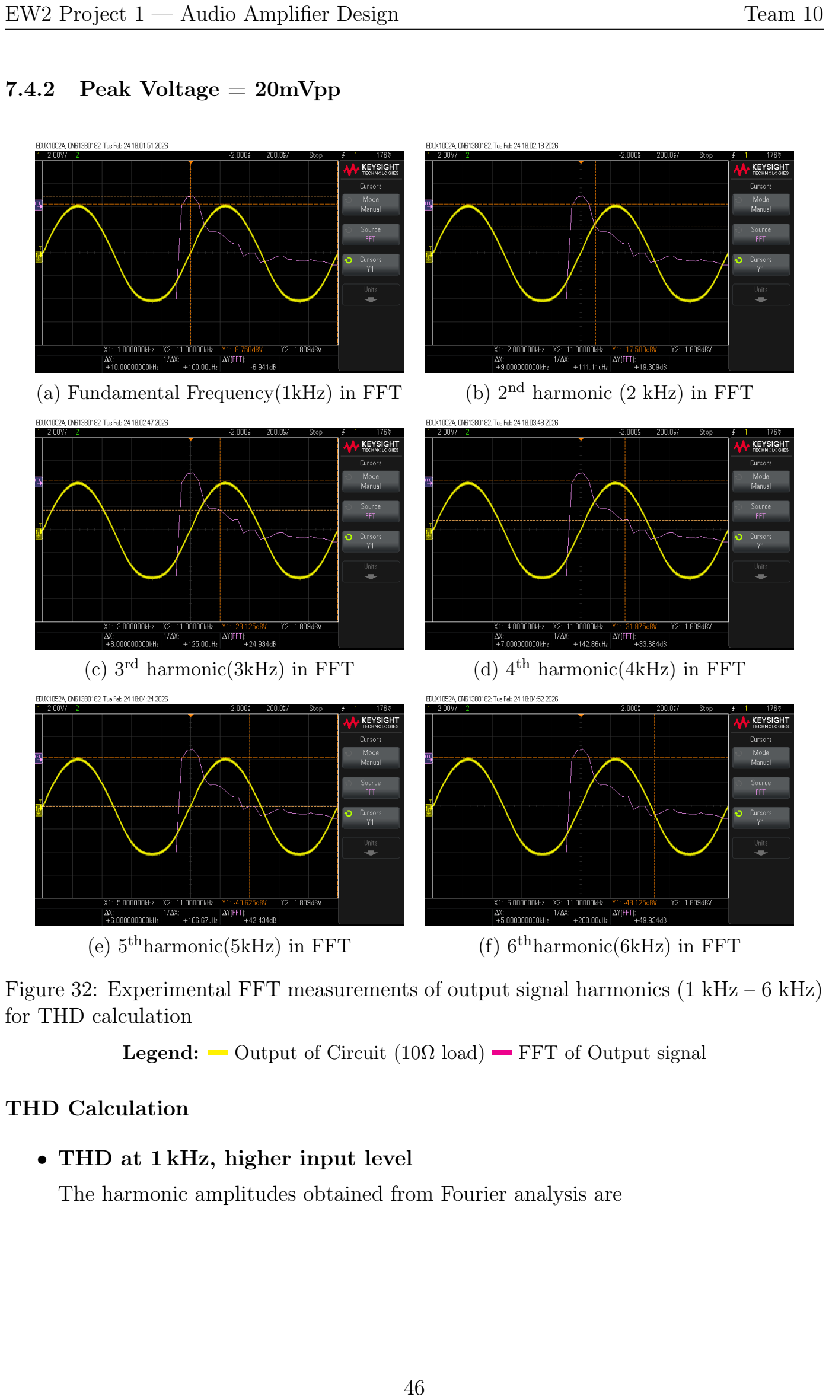
[picture p35: page 46]

### 7.4.2 Peak Voltage = 20mVpp

(a) Fundamental Frequency(1kHz) in FFT | (b) 2nd harmonic (2 kHz) in FFT
(c) 3rd harmonic(3kHz) in FFT | (d) 4th harmonic(4kHz) in FFT
(e) 5thharmonic(5kHz) in FFT | (f) 6thharmonic(6kHz) in FFT

Figure 32: Experimental FFT measurements of output signal harmonics (1 kHz – 6 kHz) for THD calculation

Legend: | Output of Circuit (10Ω load) | FFT of Output signal

THD Calculation

- THD at 1 kHz, higher input level

The harmonic amplitudes obtained from Fourier analysis are

V1 = 8.750 dBV
V2 = −17.500 dBV
V3 = −23.125 dBV
V4 = −31.875 dBV
V5 = −40.625 dBV
V6 = −48.125 dBV

Converting from dBV to volts using

V = 10⁽dBV/20)

V1 ≈ 2.74 V
V2 ≈ 0.133 V
V3 ≈ 0.0698 V
V4 ≈ 0.0254 V
V5 ≈ 0.0093 V
V6 ≈ 0.0039 V

The Total Harmonic Distortion (THD) is defined as

THD =

p
V

2
2 + V

2
3 + V

2
4 + V

2
5 + V

2
6
V1

Substituting the values,

p
(0.133)² + (0.0698)² + (0.0256)² + (0.0093)² + (0.0039)² ≈ 0.153

THD = 0.153
2.74

≈ 0.0558

THD ≈ 5.6%

### 7.5 Slew Rate Analysis

### 7.5.1 Theory

The slew rate (SR) defines the maximum rate of change of the output voltage:

SR =

dvout
dt
max

[V/µs]

The slew rate is typically limited by the internal capacitances of the transistors and op-amp, and the maximum current available to charge/discharge these capacitances:

SR =

Imax

Cinternal

### 7.5.2 LTSpice Simulation Slew Rate

The slew rate of the amplifier was estimated from the transient simulation by observing the slope of the output waveform near the zero-crossing point. At this point the slope of a sinusoidal signal is maximum, making it suitable for estimating the maximum rate of change of the output voltage.
The slew rate is calculated from the slope of the waveform as

Slew Rate =

dV
dt

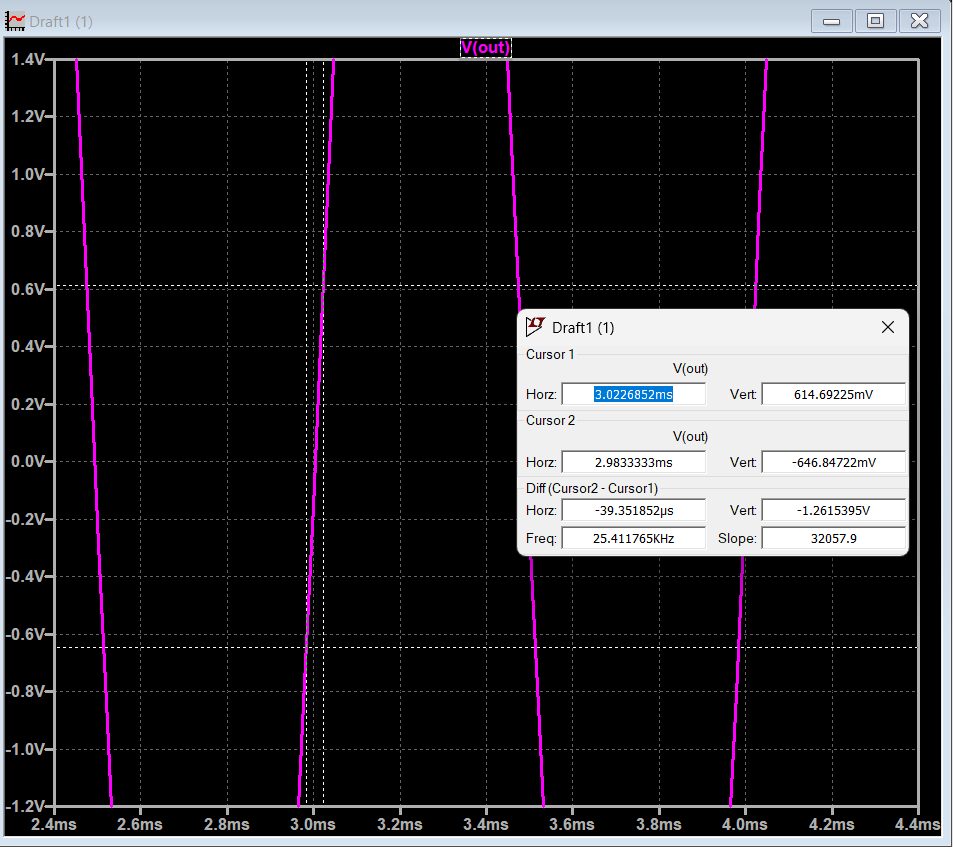
[picture p36: figure]

Figure 33: Slew rate measurement from the slope of the output waveform near the zero-crossing point in LTSpice.

From the measured slope of the output waveform in LTspice, the slew rate is

SR ≈ 0.0321 V/µs.

### 7.5.3 Hardware Slew Rate

From the MATLAB-parsed plot of the measured output waveform(plot taken Figure: Hardware Overall Output, 20mVp-p input), the instantaneous rate of change of the signal was analysed. The slope of the waveform was evaluated in the region around the zero-crossing point, where the rate of change of a sinusoidal signal is maximum. The instantaneous values of dV
dt were obtained from the plot, and the average slope in this region was calculated. This average value of slope at the waveform crossing is reported as the slew rate of the hardware amplifier.

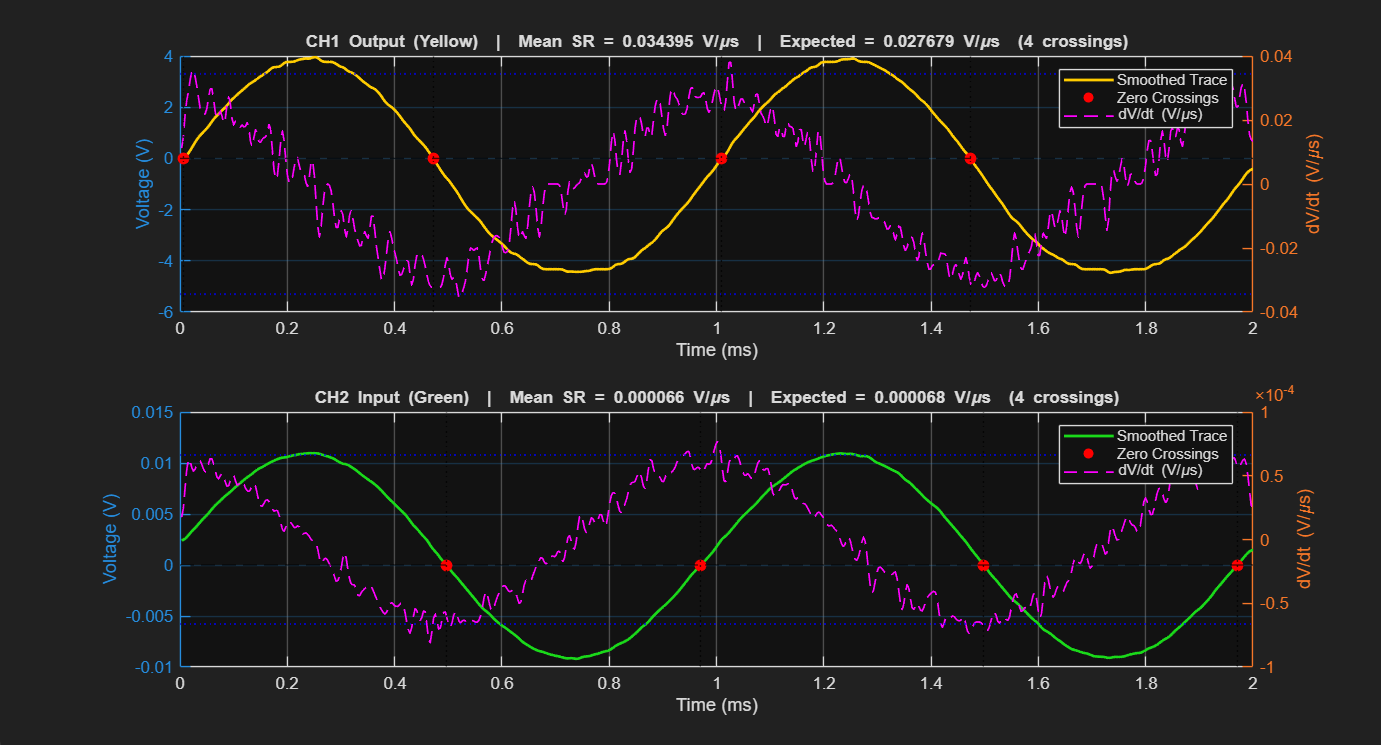
[picture p37: figure]

Figure 34: From the our Hardware output plot we extracted instantaneous rate of change of waveform, and average value of the slope at Waveform zero–crossing is reported as Slew rate

Table 2: Slew Rate Analysis Results (Output Channel)

Parameter | Value
Mean Slew Rate Median Slew Rate | 0.034395 V/µs 0.033844 V/µs

## 8 Conclusion

A four-stage audio amplifier was successfully designed, simulated, and tested:

1. The BJT differential pair pre-amplifier provides a differential gain of ≈ 21.75 with a CMRR of ≈ 85 dB, offering good rejection of common-mode noise.
2. The CE gain stage provides the primary voltage amplification (gain ≈ 22.56) with a maximum output swing of 9.05 Vpp, using voltage divider biasing for thermal stability.
3. The active band-pass filter confines the signal to the audio band (20 Hz – 20 kHz) with unity passband gain, using an inverting op-amp topology.
4. The Class AB power amplifier provides the current drive capability for the loudspeaker load at unity voltage gain, with minimal crossover distortion.

The overall voltage gain of ≈ 490 (53.8 dB) was verified through both AC and transient simulations. The amplifier meets the design specifications for gain, bandwidth, and distortion performance.

## 9 Link to Demo on Hardware Circuit

Amplifier Demo (https://drive.google.com/file/d/1ZmUlm0iqM6ke-2IvJp_5kiaf6G8Ljte-/view?usp=sharing)
