Y-K1n9/Audio-Amplifier/Report/Individual Component Analysis.pdf

# PROJECT

# SIMULATION

# AUDIO AMPLIFIER (INDIVIDUAL COMPONENTS)

# TEAM

YOGESH KRISHNA – 2024102035 ANUMAY RAI – 2025122013

### TABLE NUMBER – 10 ROOM – N117

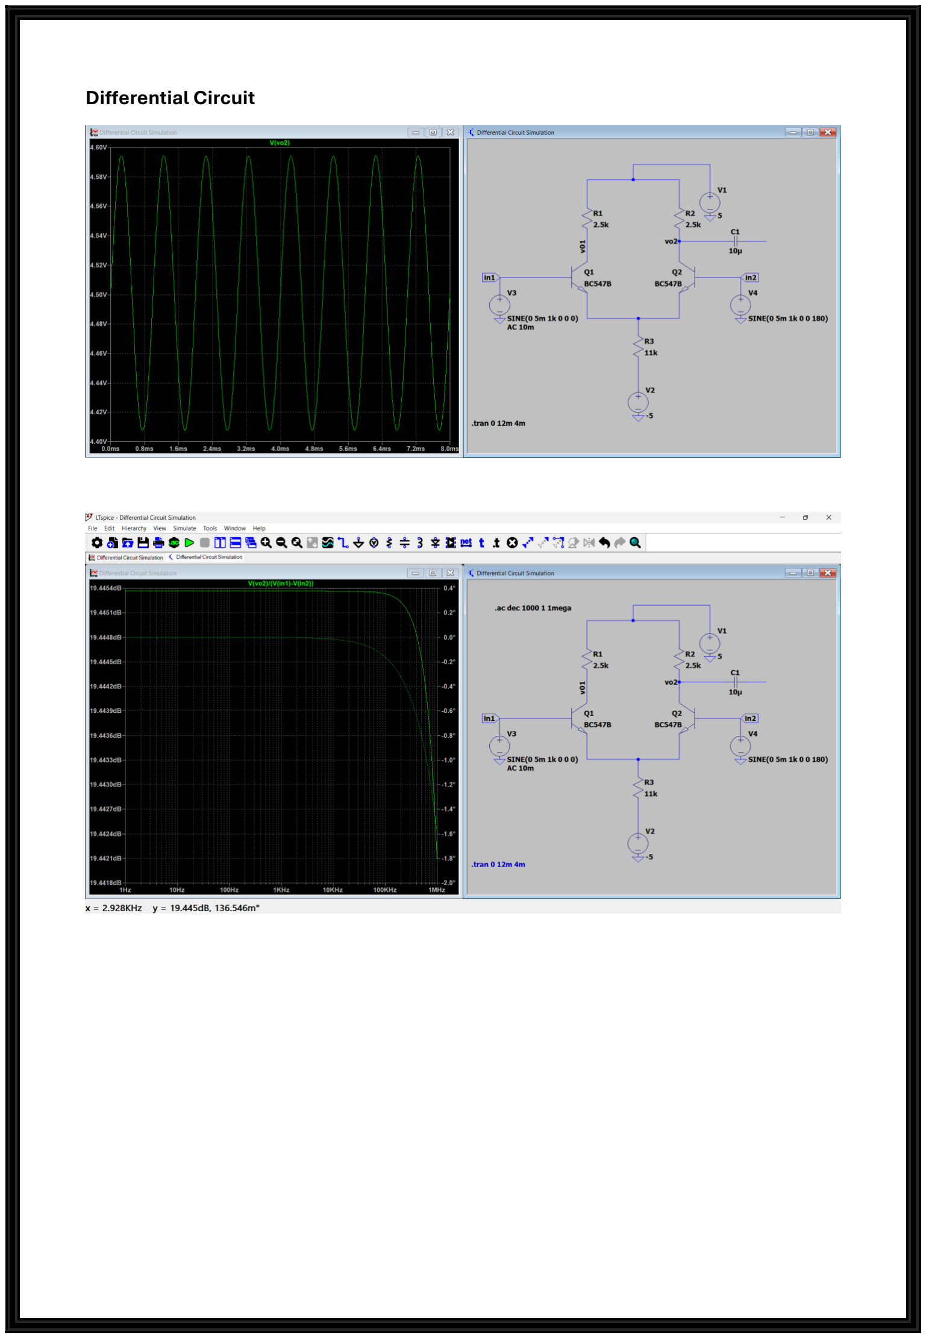
[picture p38: page 2]

Differential Circuit

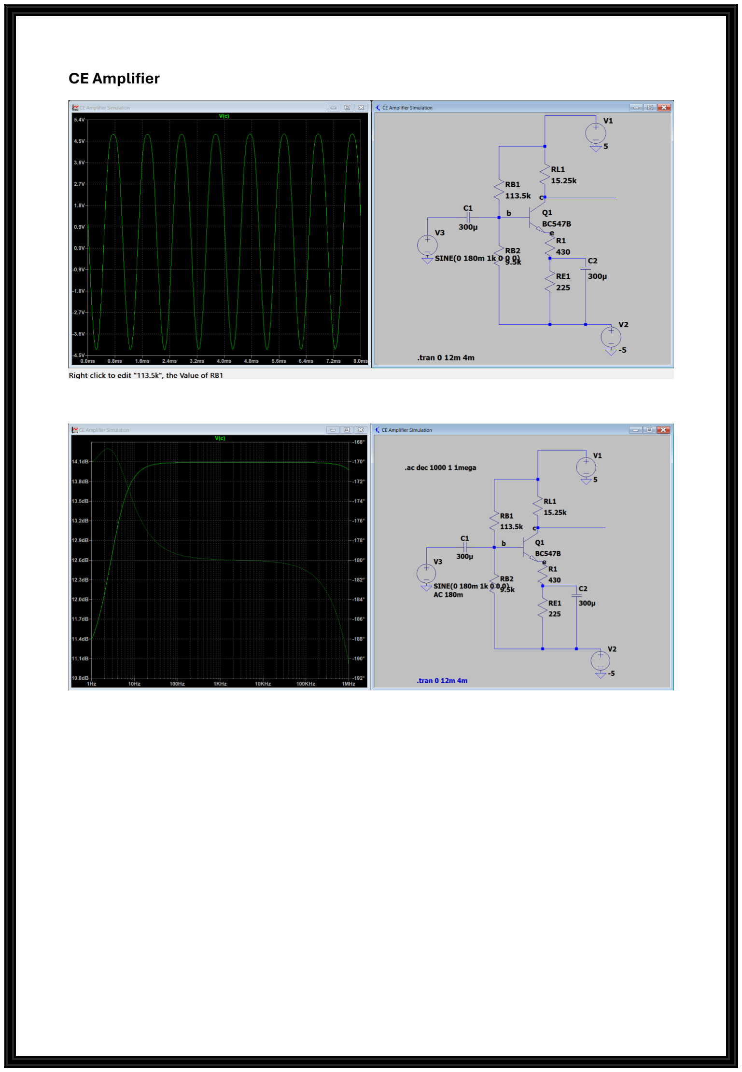
[picture p39: page 3]

CE Amplifier

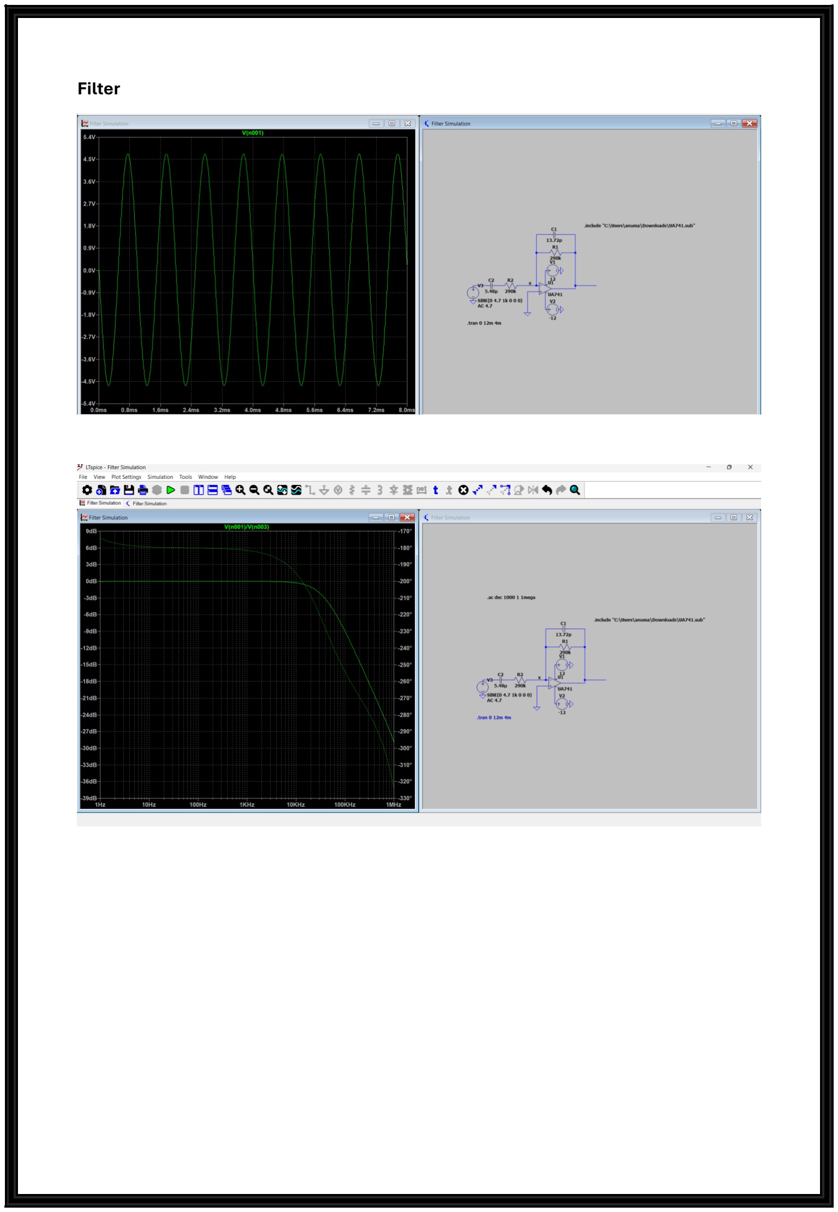
[picture p40: page 4]

Filter

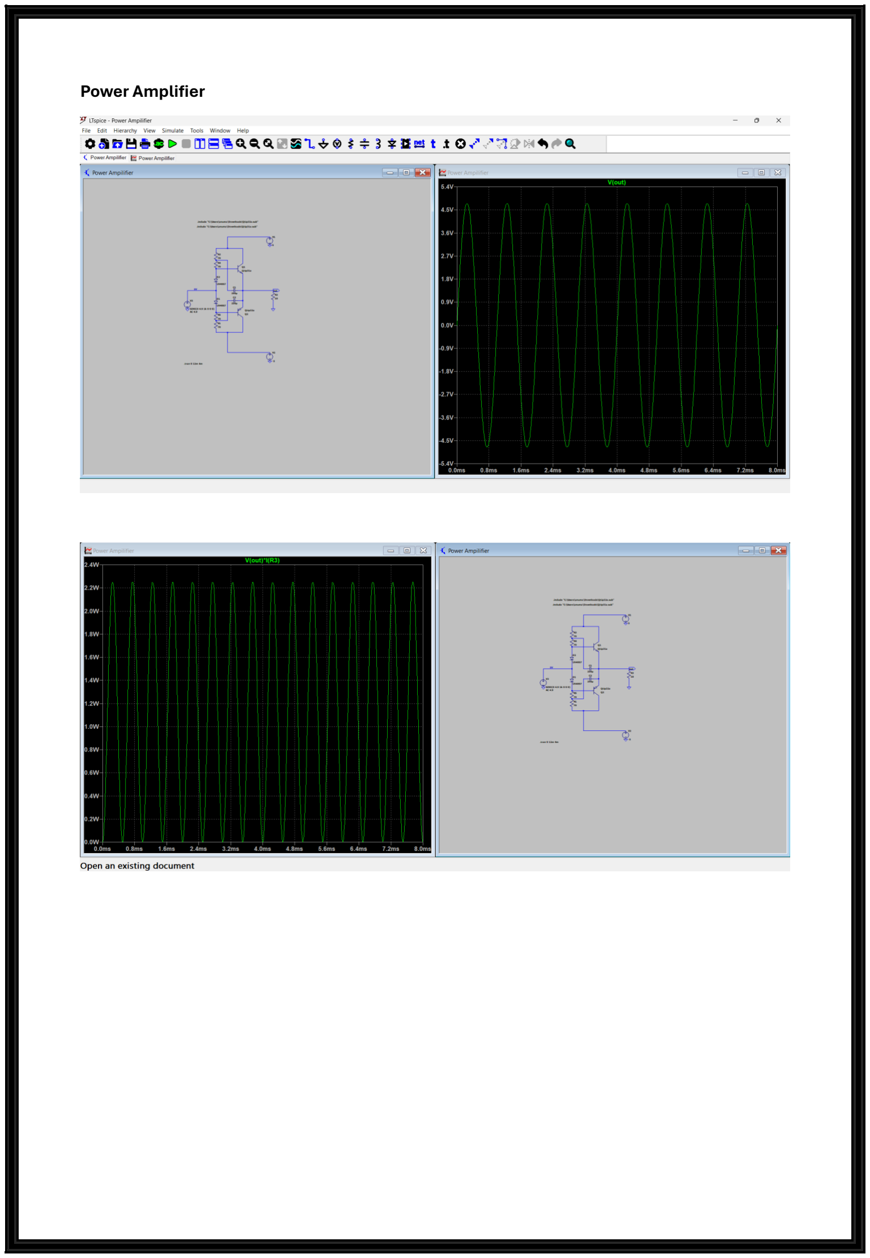
[picture p41: page 5]

Power Amplifier
