Y-K1n9/Audio-Amplifier/Components/CE Amplifier Simulation.asc

C1: cap; 300µ
C2: cap; 300µ
Q1: npn; BC547B
R1: res; 430
RB1: res; 113.5k
RB2: res; 9.5k
RE1: res; 225
RL1: res; 15.25k
V1: voltage; 5
V2: voltage; -5
V3: voltage; SINE(0 180m 1k 0 0 0); AC 180m
Named nets: 0, b, e, c
.tran 0 12m 4m
.ac dec 1000 1 1mega
