Y-K1n9/Audio-Amplifier/Components/Differential Circuit Simulation.asc

C1: cap; 10µ
Q1: npn; BC547B
Q2: npn; BC547B
R1: res; 2.5k
R2: res; 2.5k
R3: res; 11k
R4: res; 1Mega
V1: voltage; 5
V2: voltage; -5
V3: voltage; SINE(0 5m 1k 0 0 0); AC 10m
V4: voltage; SINE(0 5m 1k 0 0 180)
Named nets: 0, in1, in2, v01, vo2
.tran 0 12m 4m
.ac dec 1000 1 1mega
