Y-K1n9/Audio-Amplifier/Components/Filter Simulation.asc

C1: cap; 13.72p
C2: cap; 5.48µ
R1: res; 290k
R2: res; 290k
U1: opamp2; UA741
V1: voltage; 12
V2: voltage; -12
V3: voltage; SINE(0 4.7 1k 0 0 0); AC 4.7
Named nets: 0, x
.tran 0 12m 4m
.inc UA741.sub
.ac dec 1000 1 1mega
