Y-K1n9/Audio-Amplifier/Components/Full Circuit Analysis Simulation.asc

C1: cap; 300µ
C3: cap; 300µ
C4: cap; 10µ
C5: cap; 13.72p
C6: cap; 5.48µ
C7: cap; 250µ
C8: cap; 250µ
D1: diode; 1N4007
D2: diode; 1N4007
Q1: npn; BC547B
Q2: npn; BC547B
Q3: npn; BC547B
Q4: npn; Qtip31a
Q5: pnp; Qtip32a
R1: res; 430
R2: res; 70
R3: res; 12k
R4: res; 14.5k
R5: res; 11k
R6: res; 290k
R7: res; 290k
R8: res; 70
R9: res; 10
R10: res; 70
R11: res; 70
RB1: res; 113.5k
RB2: res; 9.5k
RE1: res; 225
RL1: res; 16k
U1: opamp2; UA741
V1: voltage; 12
V2: voltage; 5
V3: voltage; -5
V4: voltage; 5
V5: voltage; -5
V6: voltage; SINE(0 5m 1k 0 0 0); AC 10m
V7: voltage; SINE(0 5m 1k 0 0 180)
V8: voltage; -12
V9: voltage; 5
V10: voltage; -5
V11: voltage; -1
Named nets: 0, b, e, c, x, out, in1, in2
.tran 0 20m 10m
.inc UA741.sub
.inc Qtip31a.sub
.inc Qtip32a.sub
.four 1k V(out)
