Y-K1n9/Audio-Amplifier/Components/Power Ampilifier.asc

C1: cap; 250µ
C2: cap; 250µ
D1: diode; 1N4007
D2: diode; 1N4007
Q1: npn; Qtip31a
Q2: pnp; Qtip32a
R1: res; 70
R2: res; 70
R3: res; 10
R4: res; 70
R5: res; 70
V1: voltage; 5
V2: voltage; -5
V3: voltage; SINE(0 4.9 1k 0 0 0); AC 4.9
Named nets: 0, out
.tran 0 12m 4m
.inc Qtip31a.sub
.inc Qtip32a.sub
.ac dec 1000 1 1mega
